domenipavec/usb-vga-computer-control/README.md

# usb-vga-computer-control

## Installation

`sudo apt-get install python-opencv v4l-utils python-pip`
`sudo pip install -r python-software/requirements.txt`
