domenipavec/usb-vga-computer-control/kicad/prototypes/2/prototype1.kicad_pcb

## KiCad design kicad/prototypes/2/prototype1.kicad_pcb (2017-01-03)

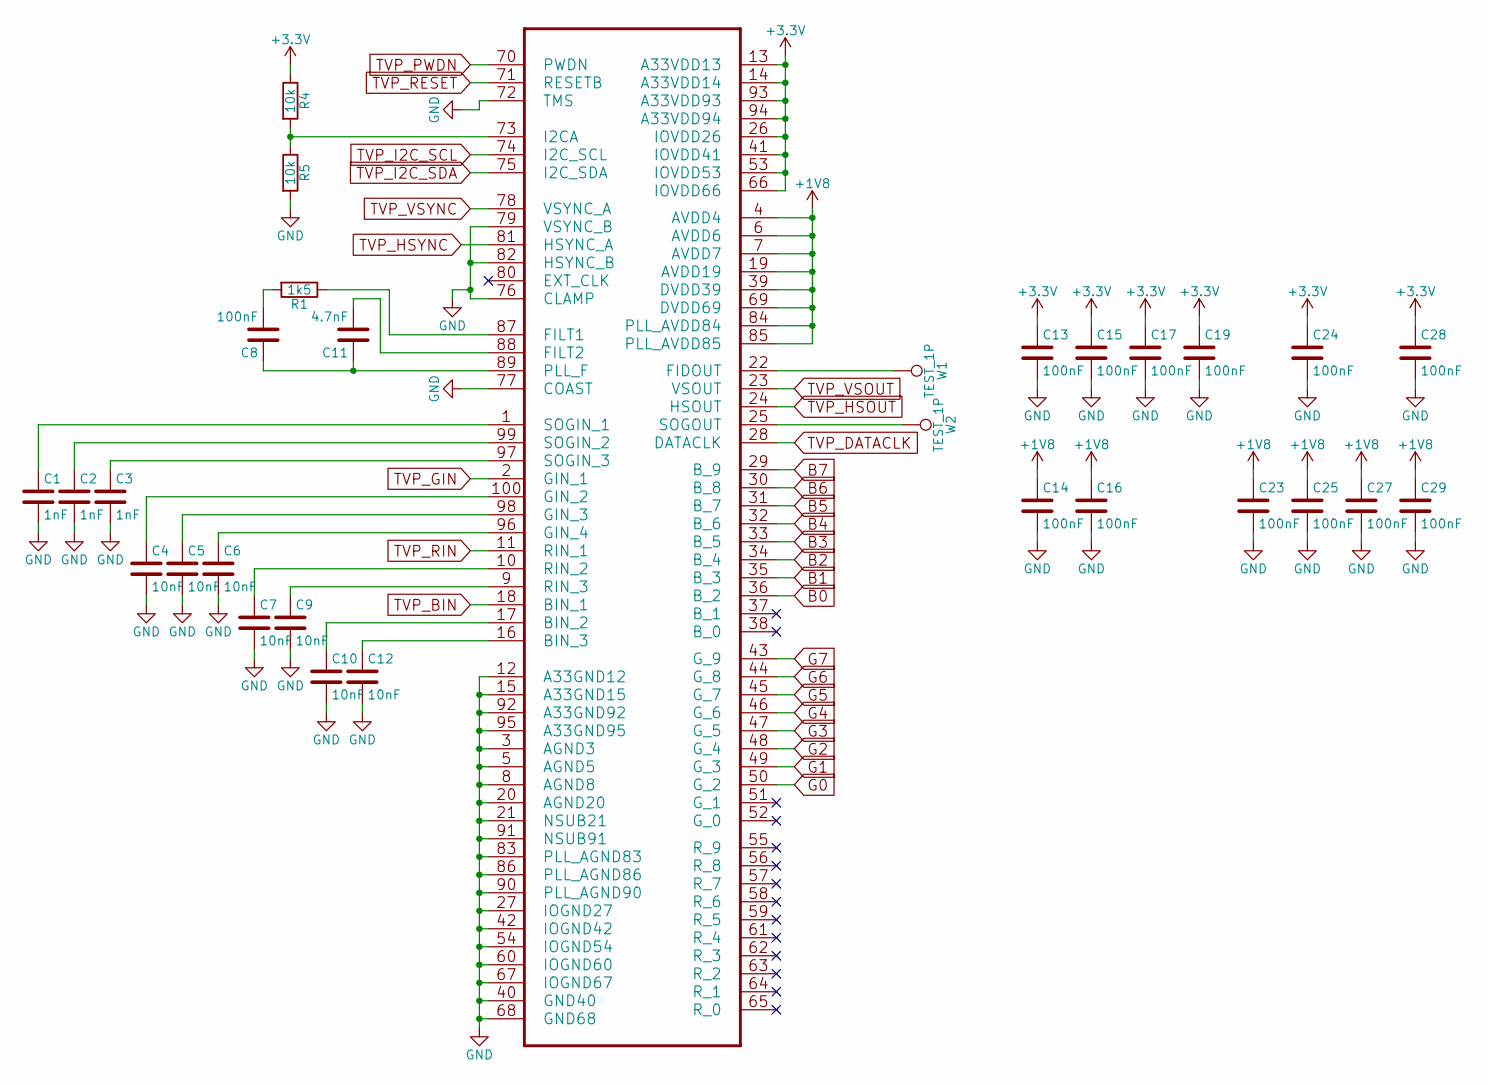
[picture p1: schematic tvp7002.sch]

Parts:
C1, C2, C3: 1nF; C_0402
C4, C5, C6, C7, C9, C10, C12: 10nF; C_0402
C8, C13, C14, C15, C16, C17, C19, C23, C24, C25, C27, C28, C29: 100nF; C_0402
C11: 4.7nF; C_0805
R1: 1k5; R_0805
R4, R5: 10k; R_0805
U1: TVP7002; LQFP-100_14x14mm_Pitch0.5mm
W1, W2: TEST_1P; Measurement_Point_Round-SMD-Pad_Small

Connections:
+1V8: C14.1, C16.1, C23.1, C25.1, C27.1, C29.1, U1.4 (AVDD4), U1.6 (AVDD6), U1.7 (AVDD7), U1.19 (AVDD19), U1.39 (DVDD39), U1.69 (DVDD69), U1.84 (PLL_AVDD84), U1.85 (PLL_AVDD85); also elsewhere on the board
+3V3: C13.1, C15.1, C17.1, C19.1, C24.1, C28.1, R4.1, U1.13 (A33VDD13), U1.14 (A33VDD14), U1.26 (IOVDD26), U1.41 (IOVDD41), U1.53 (IOVDD53), U1.66 (IOVDD66), U1.93 (A33VDD93), U1.94 (A33VDD94); also elsewhere on the board
B0: U1.36 (B_2); also elsewhere on the board
B1: U1.35 (B_3); also elsewhere on the board
B2: U1.34 (B_4); also elsewhere on the board
B3: U1.33 (B_5); also elsewhere on the board
B4: U1.32 (B_6); also elsewhere on the board
B5: U1.31 (B_7); also elsewhere on the board
B6: U1.30 (B_8); also elsewhere on the board
B7: U1.29 (B_9); also elsewhere on the board
G0: U1.50 (G_2); also elsewhere on the board
G1: U1.49 (G_3); also elsewhere on the board
G2: U1.48 (G_4); also elsewhere on the board
G3: U1.47 (G_5); also elsewhere on the board
G4: U1.46 (G_6); also elsewhere on the board
G5: U1.45 (G_7); also elsewhere on the board
G6: U1.44 (G_8); also elsewhere on the board
G7: U1.43 (G_9); also elsewhere on the board
GND: C1.2, C2.2, C3.2, C4.2, C5.2, C6.2, C7.2, C9.2, C10.2, C12.2, C13.2, C14.2, C15.2, C16.2, C17.2, C19.2, C23.2, C24.2, C25.2, C27.2, C28.2, C29.2, R5.2, U1.3 (AGND3), U1.5 (AGND5), U1.8 (AGND8), U1.12 (A33GND12), U1.15 (A33GND15), U1.20 (AGND20), U1.21 (NSUB21), U1.27 (IOGND27), U1.40 (GND40), U1.42 (IOGND42), U1.54 (IOGND54), U1.60 (IOGND60), U1.67 (IOGND67), U1.68 (GND68), U1.72 (TMS), U1.76 (CLAMP), U1.77 (COAST), U1.79 (VSYNC_B), U1.82 (HSYNC_B), U1.83 (PLL_AGND83), U1.86 (PLL_AGND86), U1.90 (PLL_AGND90), U1.91 (NSUB91), U1.92 (A33GND92), U1.95 (A33GND95); also elsewhere on the board
unnamed: C1.1, U1.1 (SOGIN_1)
unnamed: C2.1, U1.99 (SOGIN_2)
unnamed: C3.1, U1.97 (SOGIN_3)
unnamed: C4.1, U1.100 (GIN_2)
unnamed: C5.1, U1.98 (GIN_3)
unnamed: C6.1, U1.96 (GIN_4)
unnamed: C7.1, U1.10 (RIN_2)
unnamed: C8.2, R1.2
unnamed: C9.1, U1.9 (RIN_3)
unnamed: C10.1, U1.17 (BIN_2)
unnamed: C8.1, C11.1, U1.89 (PLL_F)
unnamed: C11.2, U1.88 (FILT2)
unnamed: C12.1, U1.16 (BIN_3)
unnamed: R1.1, U1.87 (FILT1)
unnamed: R4.2, R5.1, U1.73 (I2CA)
unnamed: U1.22 (FIDOUT), W1.1
unnamed: U1.25 (SOGOUT), W2.1
TVP_BIN: U1.18 (BIN_1); also elsewhere on the board
TVP_DATACLK: U1.28 (DATACLK); also elsewhere on the board
TVP_GIN: U1.2 (GIN_1); also elsewhere on the board
TVP_HSOUT: U1.24 (HSOUT); also elsewhere on the board
TVP_HSYNC: U1.81 (HSYNC_A); also elsewhere on the board
TVP_I2C_SCL: U1.74 (I2C_SCL); also elsewhere on the board
TVP_I2C_SDA: U1.75 (I2C_SDA); also elsewhere on the board
TVP_PWDN: U1.70 (PWDN); also elsewhere on the board
TVP_RESET: U1.71 (RESETB); also elsewhere on the board
TVP_RIN: U1.11 (RIN_1); also elsewhere on the board
TVP_VSOUT: U1.23 (VSOUT); also elsewhere on the board
TVP_VSYNC: U1.78 (VSYNC_A); also elsewhere on the board

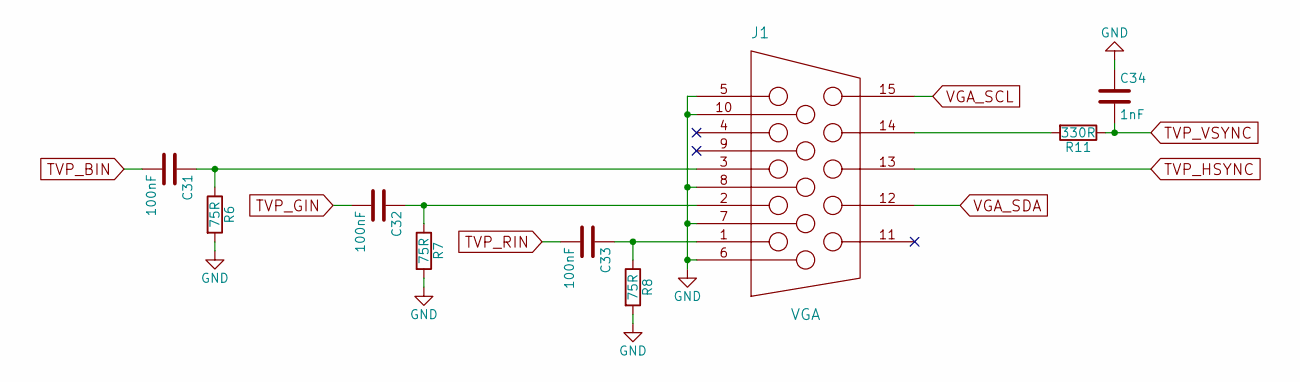
[picture p2: schematic vga.sch]

Parts:
C31, C32, C33: 100nF; C_0402
C34: 1nF; C_0402
J1: VGA
R6, R7, R8: 75R; R_0805
R11: 330R; R_0805

Connections:
AVR_MOSI: J1.12 (ID1/SDA); also elsewhere on the board
AVR_SCK: J1.15 (ID3/SCL); also elsewhere on the board
GND: C34.1, J1.5 (GND_HSYNC), J1.6 (RED_RTN), J1.7 (GREEN_RTN), J1.8 (BLUE_RTN), J1.10 (GND_VSYNC), R6.2, R7.2, R8.2; also elsewhere on the board
unnamed: C31.1, J1.3 (BLUE), R6.1
unnamed: C32.1, J1.2 (GREEN), R7.1
unnamed: C33.1, J1.1 (RED), R8.1
unnamed: J1.14 (VSYNC), R11.2
TVP_BIN: C31.2; also elsewhere on the board
TVP_GIN: C32.2; also elsewhere on the board
TVP_HSYNC: J1.13 (HSYNC); also elsewhere on the board
TVP_RIN: C33.2; also elsewhere on the board
TVP_VSYNC: C34.2, R11.1; also elsewhere on the board

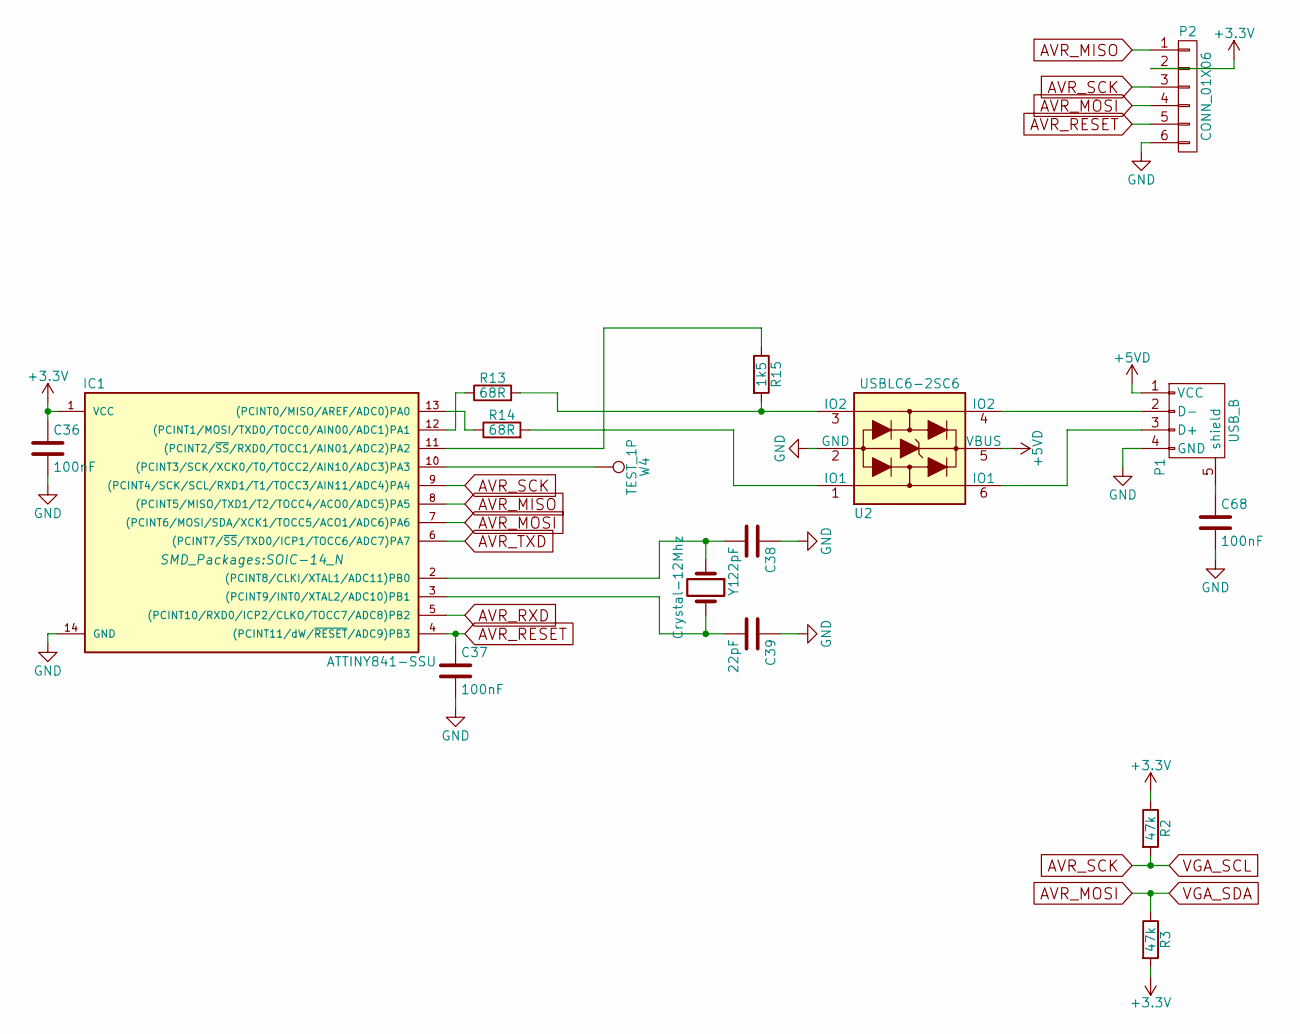
[picture p3: schematic avr.sch]

Parts:
C36, C37, C68: 100nF; C_0402
C38, C39: 22pF; C_0805
IC1: ATTINY841-SSU; SOIC-14_N
P1: USB_B
P2: CONN_01X06; ATTINY841-SPI
R2, R3: 47k; R_0805
R13, R14: 68R; R_0805
R15: 1k5; R_0805
U2: USBLC6-2SC6; SOT-23-6
W4: TEST_1P; Measurement_Point_Round-SMD-Pad_Small
Y1: Crystal-12Mhz; Crystal_HC49-U_Vertical

Connections:
+3V3: C36.1, IC1.1 (VCC), P2.2, R2.1, R3.2; also elsewhere on the board
+5VD: P1.1 (VCC), U2.5 (VBUS)
AVR_MISO: IC1.8 ((PCINT5/MISO/TXD1/T2/TOCC4/ACO0/ADC5)PA5), P2.1
AVR_MOSI: IC1.7 ((PCINT6/MOSI/SDA/XCK1/TOCC5/ACO1/ADC6)P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), P2.4, R3.1; also elsewhere on the board
AVR_RESET: C37.1, IC1.4 ((PCINT11/dW/~RESET~/ADC9)PB3), P2.5
AVR_RXD: IC1.5 ((PCINT10/RXD0/ICP2/CLKO/TOCC7/ADC8)PB2); also elsewhere on the board
AVR_SCK: IC1.9 ((PCINT4/SCK/SCL/RXD1/T1/TOCC3/AIN11/ADC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), P2.3, R2.2; also elsewhere on the board
AVR_TXD: IC1.6 ((PCINT7/~SS~/TXD0/ICP1/TOCC6/ADC7)PA7); also elsewhere on the board
GND: C36.2, C37.2, C38.1, C39.1, C68.2, IC1.14 (GND), P1.4 (GND), P2.6, U2.2 (GND); also elsewhere on the board
unnamed: C38.2, IC1.2 ((PCINT8/CLKI/XTAL1/ADC11)PB0), Y1.1
unnamed: C39.2, IC1.3 ((PCINT9/INT0/XTAL2/ADC10)PB1), Y1.2
unnamed: C68.1, P1.5 (shield)
unnamed: IC1.10 ((PCINT3/SCK/XCK0/T0/TOCC2/AIN10/ADC3)PA3), W4.1
unnamed: IC1.11 ((PCINT2/~SS~/RXD0/TOCC1/AIN01/ADC2)PA2), R15.1
unnamed: IC1.12 ((PCINT1/MOSI/TXD0/TOCC0/AIN00/ADC1)PA1), R13.1
unnamed: IC1.13 ((PCINT0/MISO/AREF/ADC0)PA0), R14.1
unnamed: P1.2 (D-), U2.4 (IO2)
unnamed: P1.3 (D+), U2.6 (IO1)
unnamed: R13.2, R15.2, U2.3 (IO2)
unnamed: R14.2, U2.1 (IO1)

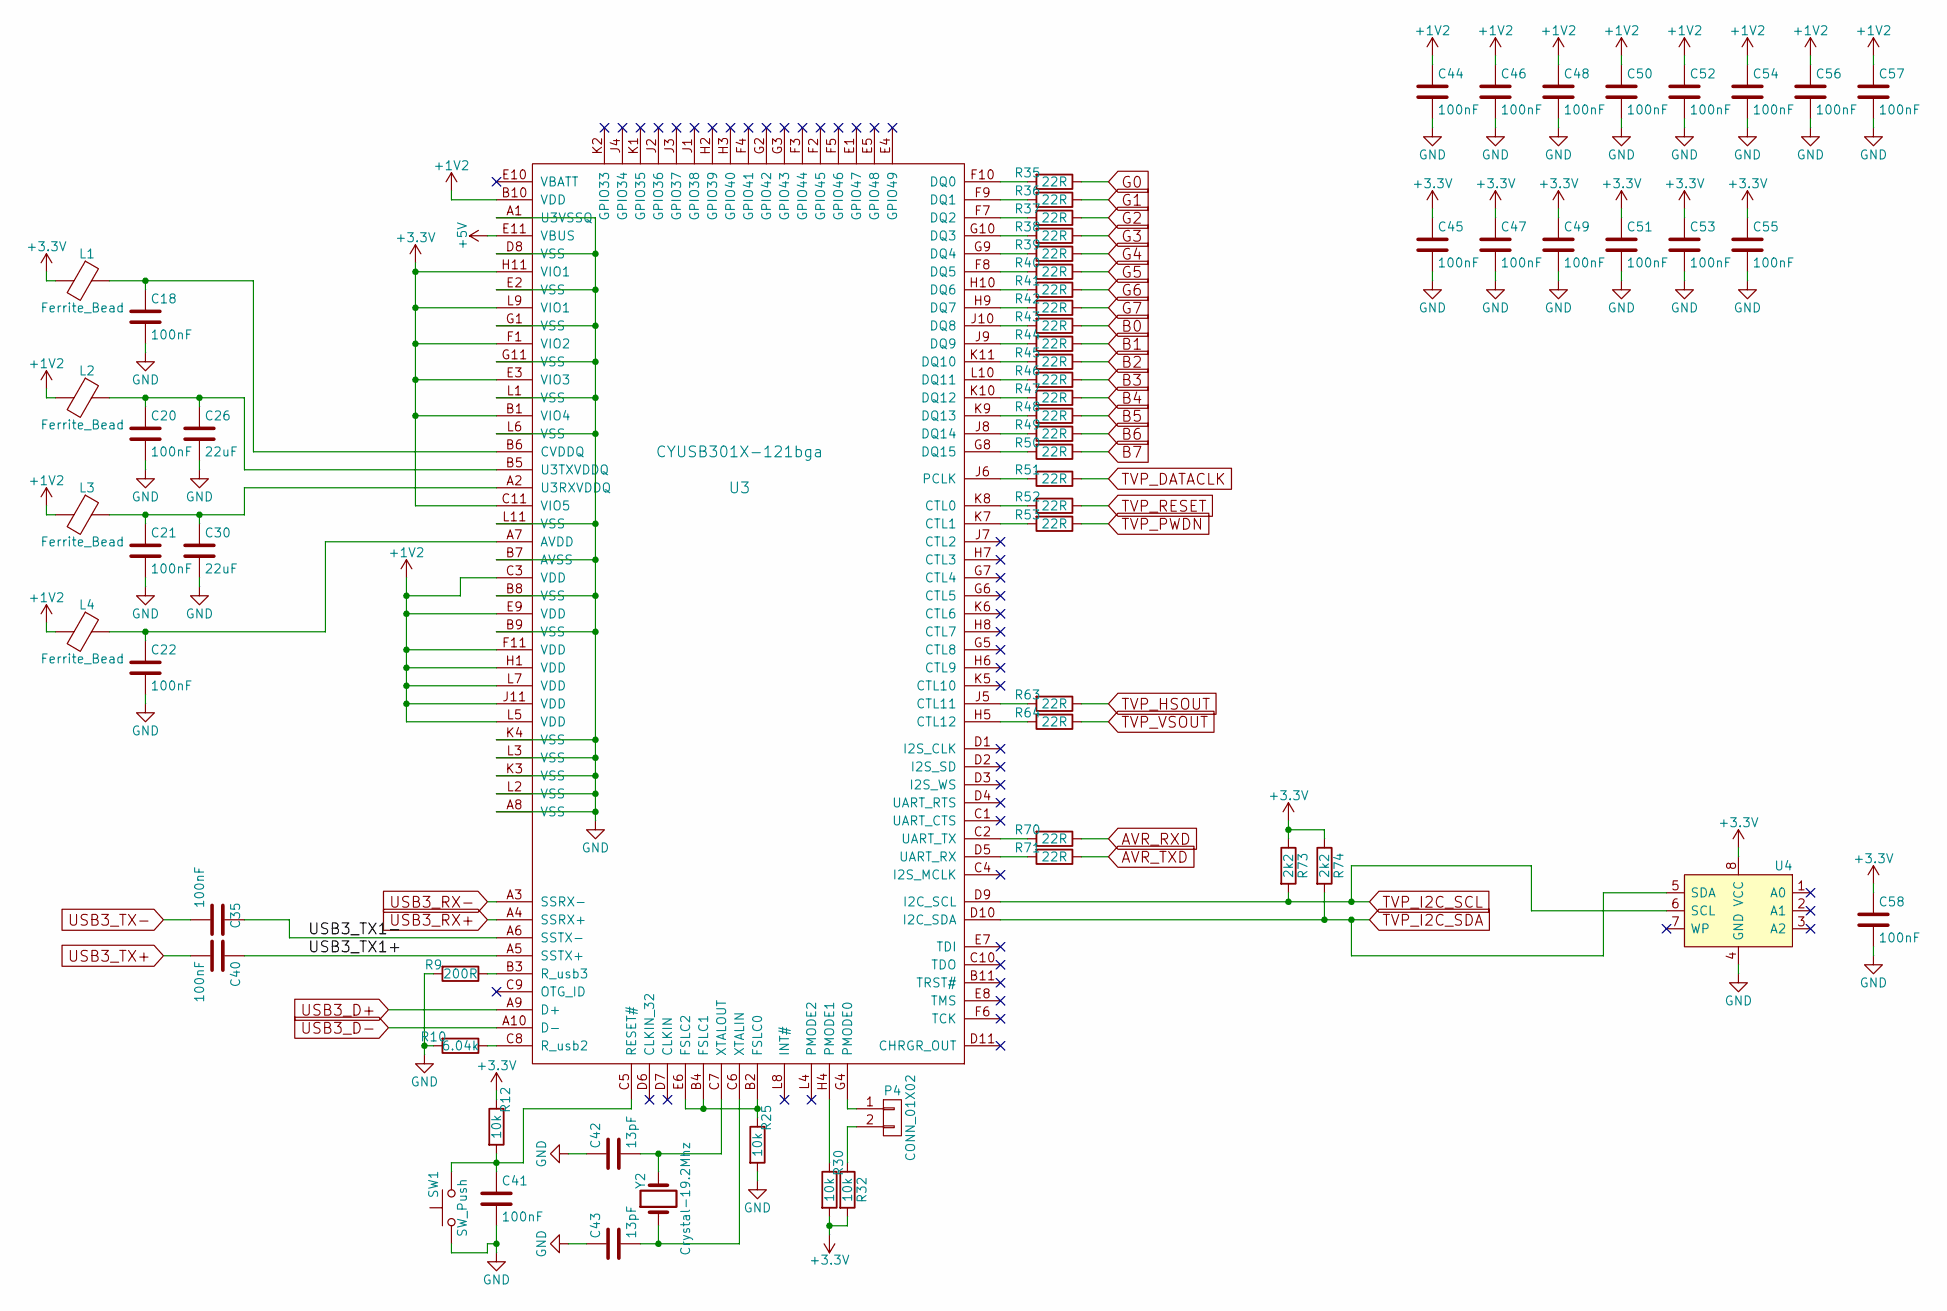
[picture p4: schematic cyusb.sch]

Parts:
C18, C20, C21, C22, C35, C40, C41, C44, C45, C46, C47, C48, C49, C50, C51, C52, C53, C54, C55, C56, C57, C58: 100nF; C_0402
C26, C30: 22uF; C_1206
C42, C43: 13pF; C_0805
L1, L2, L3, L4: Ferrite_Bead; R_0805
P4: CONN_01X02; Socket_Strip_Straight_1x02
R9: 200R; R_0402
R10: 6.04k; R_0402
R12, R25, R30, R32: 10k; R_0805
R35, R36, R37, R38, R39, R40, R41, R42, R43, R44, R45, R46, R47, R48, R49, R50, R51, R52, R53, R63, R64, R70, R71: 22R; R_0402
R73, R74: 2k2; R_0805
SW1: SW_Push; pushbutton
U3: CYUSB301X-121bga; BGA_121
U4: 24LC16; SOIC-8_3.9x4.9mm_Pitch1.27mm
Y2: Crystal-19.2Mhz; Crystal_HC49-U_Vertical

Connections:
+1V2: C44.1, C46.1, C48.1, C50.1, C52.1, C54.1, C56.1, C57.1, L2.2, L3.2, L4.2, U3.B10 (VDD), U3.C3 (VDD), U3.E9 (VDD), U3.F11 (VDD), U3.H1 (VDD), U3.J11 (VDD), U3.L5 (VDD), U3.L7 (VDD); also elsewhere on the board
+3V3: C45.1, C47.1, C49.1, C51.1, C53.1, C55.1, C58.1, L1.2, R12.1, R30.2, R32.2, R73.1, R74.1, U3.B1 (VIO4), U3.C11 (VIO5), U3.E3 (VIO3), U3.F1 (VIO2), U3.H11 (VIO1), U3.L9 (VIO1), U4.8 (VCC); also elsewhere on the board
+5V: U3.E11 (VBUS); also elsewhere on the board
/cyusb/USB3_TX1+: C40.1, U3.A5 (SSTX+)
/cyusb/USB3_TX1-: C35.1, U3.A6 (SSTX-)
AVR_RXD: R70.1; also elsewhere on the board
AVR_TXD: R71.1; also elsewhere on the board
B0: R43.1; also elsewhere on the board
B1: R44.1; also elsewhere on the board
B2: R45.1; also elsewhere on the board
B3: R46.1; also elsewhere on the board
B4: R47.1; also elsewhere on the board
B5: R48.1; also elsewhere on the board
B6: R49.1; also elsewhere on the board
B7: R50.1; also elsewhere on the board
G0: R35.1; also elsewhere on the board
G1: R36.1; also elsewhere on the board
G2: R37.1; also elsewhere on the board
G3: R38.1; also elsewhere on the board
G4: R39.1; also elsewhere on the board
G5: R40.1; also elsewhere on the board
G6: R41.1; also elsewhere on the board
G7: R42.1; also elsewhere on the board
GND: C18.2, C20.2, C21.2, C22.2, C26.2, C30.2, C41.2, C42.1, C43.1, C44.2, C45.2, C46.2, C47.2, C48.2, C49.2, C50.2, C51.2, C52.2, C53.2, C54.2, C55.2, C56.2, C57.2, C58.2, R9.2, R10.2, R25.2, SW1.1, U3.A1 (U3VSSQ), U3.A8 (VSS), U3.B7 (AVSS), U3.B8 (VSS), U3.B9 (VSS), U3.D8 (VSS), U3.E2 (VSS), U3.G1 (VSS), U3.G11 (VSS), U3.K3 (VSS), U3.K4 (VSS), U3.L1 (VSS), U3.L2 (VSS), U3.L3 (VSS), U3.L6 (VSS), U3.L11 (VSS), U4.4 (GND); also elsewhere on the board
unnamed: C18.1, L1.1, U3.B6 (CVDDQ)
unnamed: C20.1, C26.1, L2.1, U3.B5 (U3TXVDDQ)
unnamed: C21.1, C30.1, L3.1, U3.A2 (U3RXVDDQ)
unnamed: C22.1, L4.1, U3.A7 (AVDD)
unnamed: C41.1, R12.2, SW1.2, U3.C5 (RESET#)
unnamed: C42.2, U3.C7 (XTALOUT), Y2.2
unnamed: C43.2, U3.C6 (XTALIN), Y2.1
unnamed: P4.1, U3.G4 (PMODE0)
unnamed: P4.2, R32.1
unnamed: R9.1, U3.B3 (R_usb3)
unnamed: R10.1, U3.C8 (R_usb2)
unnamed: R25.1, U3.B2 (FSLC0), U3.B4 (FSLC1), U3.E6 (FSLC2)
unnamed: R30.1, U3.H4 (PMODE1)
unnamed: R35.2, U3.F10 (DQ0)
unnamed: R36.2, U3.F9 (DQ1)
unnamed: R37.2, U3.F7 (DQ2)
unnamed: R38.2, U3.G10 (DQ3)
unnamed: R39.2, U3.G9 (DQ4)
unnamed: R40.2, U3.F8 (DQ5)
unnamed: R41.2, U3.H10 (DQ6)
unnamed: R42.2, U3.H9 (DQ7)
unnamed: R43.2, U3.J10 (DQ8)
unnamed: R44.2, U3.J9 (DQ9)
unnamed: R45.2, U3.K11 (DQ10)
unnamed: R46.2, U3.L10 (DQ11)
unnamed: R47.2, U3.K10 (DQ12)
unnamed: R48.2, U3.K9 (DQ13)
unnamed: R49.2, U3.J8 (DQ14)
unnamed: R50.2, U3.G8 (DQ15)
unnamed: R51.2, U3.J6 (PCLK)
unnamed: R52.2, U3.K8 (CTL0)
unnamed: R53.2, U3.K7 (CTL1)
unnamed: R63.2, U3.J5 (CTL11)
unnamed: R64.2, U3.H5 (CTL12)
unnamed: R70.2, U3.C2 (UART_TX)
unnamed: R71.2, U3.D5 (UART_RX)
TVP_DATACLK: R51.1; also elsewhere on the board
TVP_HSOUT: R63.1; also elsewhere on the board
TVP_I2C_SCL: R73.2, U3.D9 (I2C_SCL), U4.6 (SCL); also elsewhere on the board
TVP_I2C_SDA: R74.2, U3.D10 (I2C_SDA), U4.5 (SDA); also elsewhere on the board
TVP_PWDN: R53.1; also elsewhere on the board
TVP_RESET: R52.1; also elsewhere on the board
TVP_VSOUT: R64.1; also elsewhere on the board
USB3_D+: U3.A9 (D+); also elsewhere on the board
USB3_D-: U3.A10 (D-); also elsewhere on the board
USB3_RX+: U3.A4 (SSRX+); also elsewhere on the board
USB3_RX-: U3.A3 (SSRX-); also elsewhere on the board
USB3_TX+: C40.2; also elsewhere on the board
USB3_TX-: C35.2; also elsewhere on the board

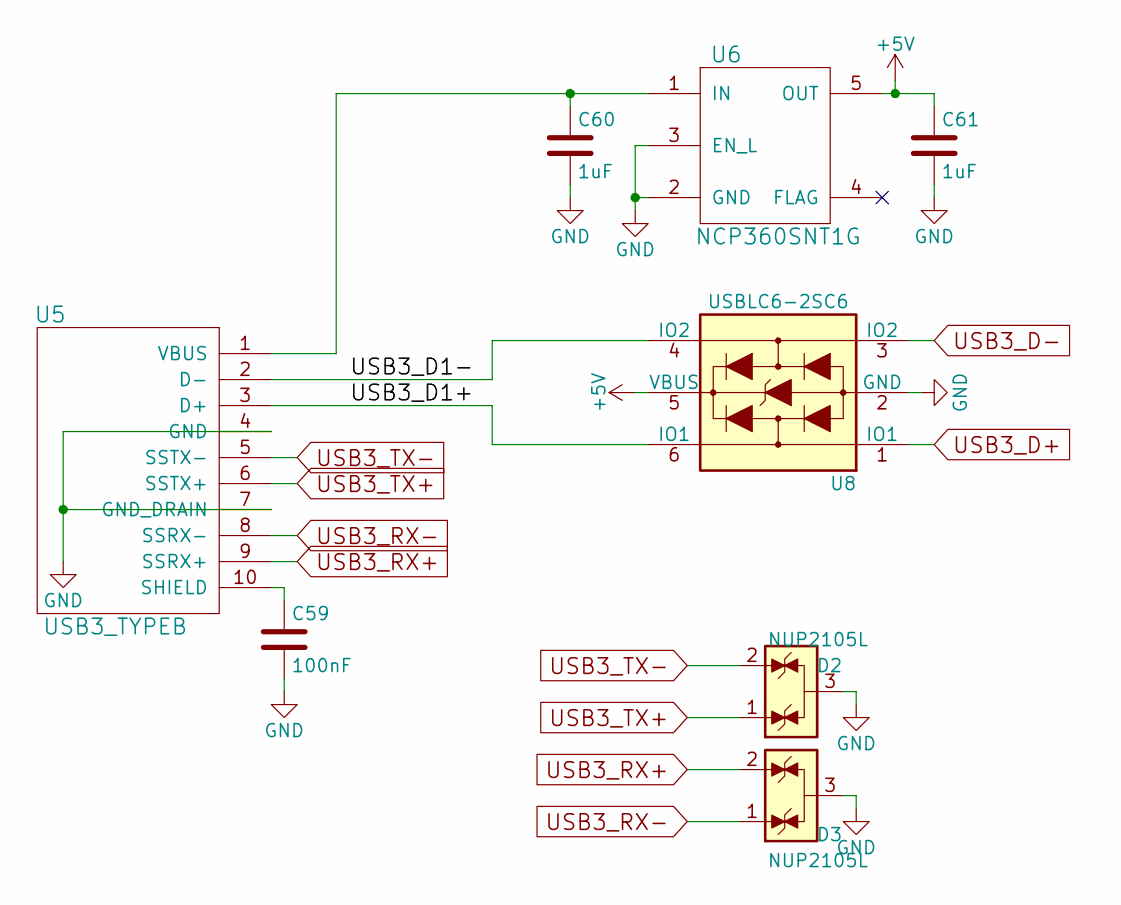
[picture p5: schematic usb3.sch]

Parts:
C59: 100nF; C_0402
C60, C61: 1uF; C_0805
D2, D3: NUP2105L; DRT
U5: USB3_TYPEB; USB3_TYPE_B
U6: NCP360SNT1G; SOT-23-5
U8: USBLC6-2SC6; SOT-23-6

Connections:
+5V: C61.1, U6.5 (OUT), U8.5 (VBUS); also elsewhere on the board
/usb3/USB3_D1+: U5.3 (D+), U8.6 (IO1)
/usb3/USB3_D1-: U5.2 (D-), U8.4 (IO2)
GND: C59.2, C60.2, C61.2, D2.3 (A), D3.3 (A), U5.4 (GND), U5.7 (GND_DRAIN), U6.2 (GND), U6.3 (EN_L), U8.2 (GND); also elsewhere on the board
unnamed: C59.1, U5.10 (SHIELD)
unnamed: C60.1, U5.1 (VBUS), U6.1 (IN)
USB3_D+: U8.1 (IO1); also elsewhere on the board
USB3_D-: U8.3 (IO2); also elsewhere on the board
USB3_RX+: D3.2 (K), U5.9 (SSRX+); also elsewhere on the board
USB3_RX-: D3.1 (K), U5.8 (SSRX-); also elsewhere on the board
USB3_TX+: D2.1 (K), U5.6 (SSTX+); also elsewhere on the board
USB3_TX-: D2.2 (K), U5.5 (SSTX-); also elsewhere on the board

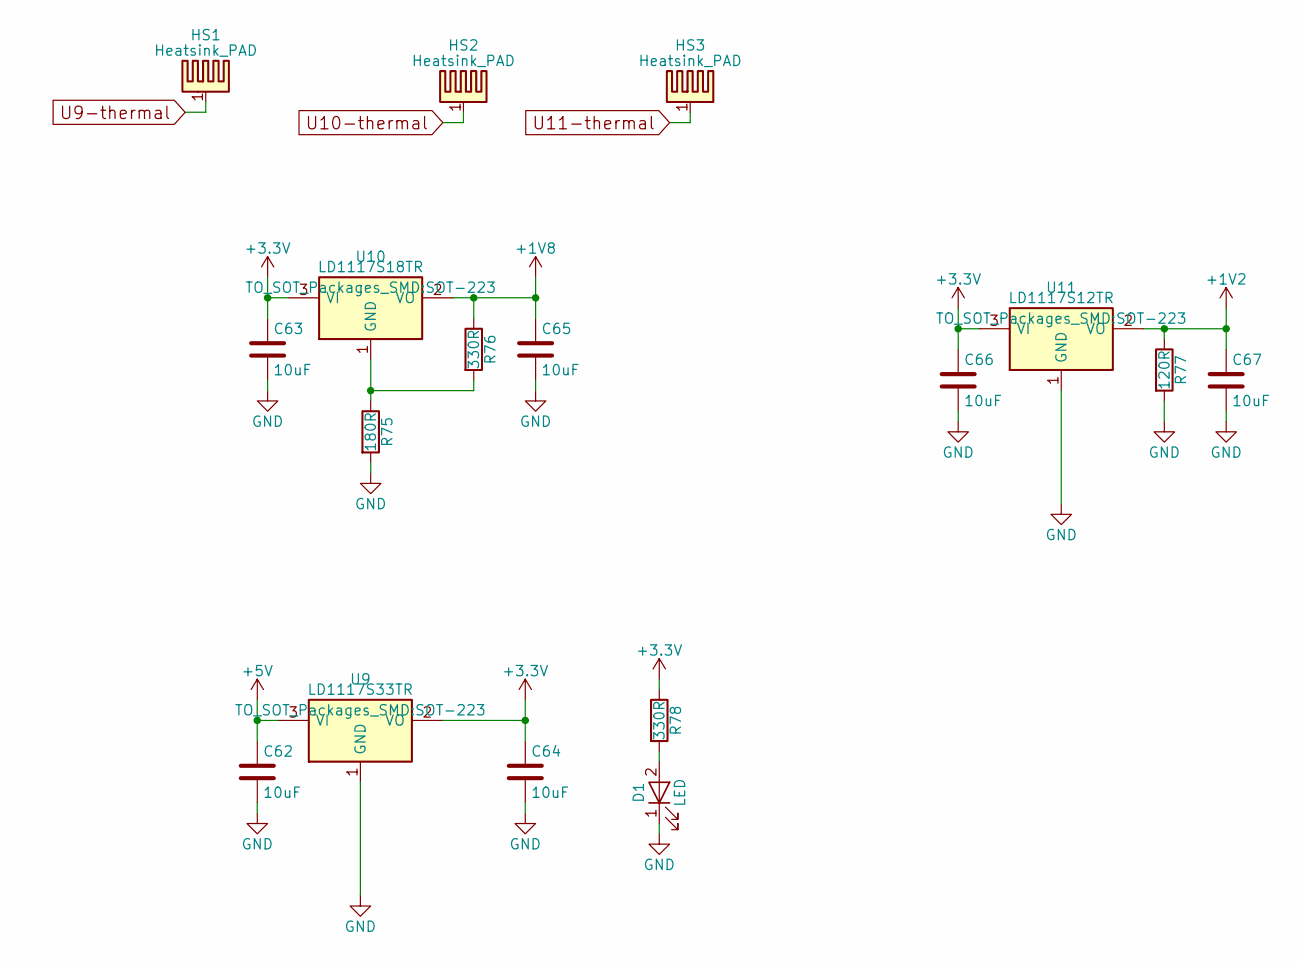
[picture p6: schematic power.sch]

Parts:
C62, C63, C64, C65, C66, C67: 10uF; C_0805
D1: LED; LED-3MM
HS1, HS2, HS3: Heatsink_PAD; Measurement_Point_Round-SMD-Pad_Small
R75: 180R; R_0805
R76, R78: 330R; R_0805
R77: 120R; R_0805
U9: LD1117S33TR; SOT-223
U10: LD1117S18TR; SOT-223
U11: LD1117S12TR; SOT-223

Connections:
+1V2: C67.1, R77.1, U11.2 (VO); also elsewhere on the board
+1V8: C65.1, R76.1, U10.2 (VO); also elsewhere on the board
+3V3: C63.1, C64.1, C66.1, R78.1, U9.2 (VO), U10.3 (VI), U11.3 (VI); also elsewhere on the board
+5V: C62.1, U9.3 (VI); also elsewhere on the board
GND: C62.2, C63.2, C64.2, C65.2, C66.2, C67.2, D1.1 (K), R75.2, R77.2, U9.1 (GND), U11.1 (GND); also elsewhere on the board
unnamed: D1.2 (A), R78.2
unnamed: R75.1, R76.2, U10.1 (GND)
U9-thermal: U9.4
U10-thermal: U10.4
U11-thermal: U11.4

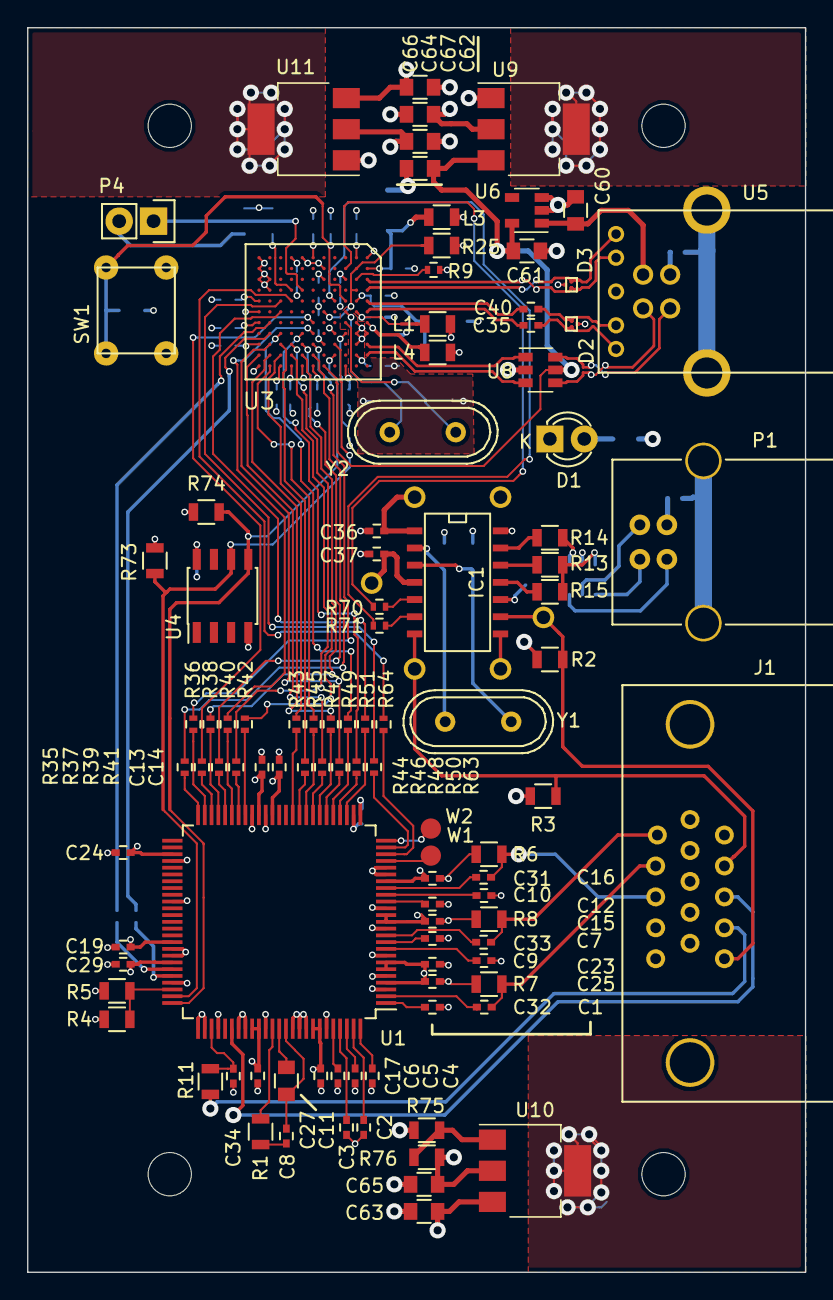
[picture p7: board prototype1.kicad_pcb from above]

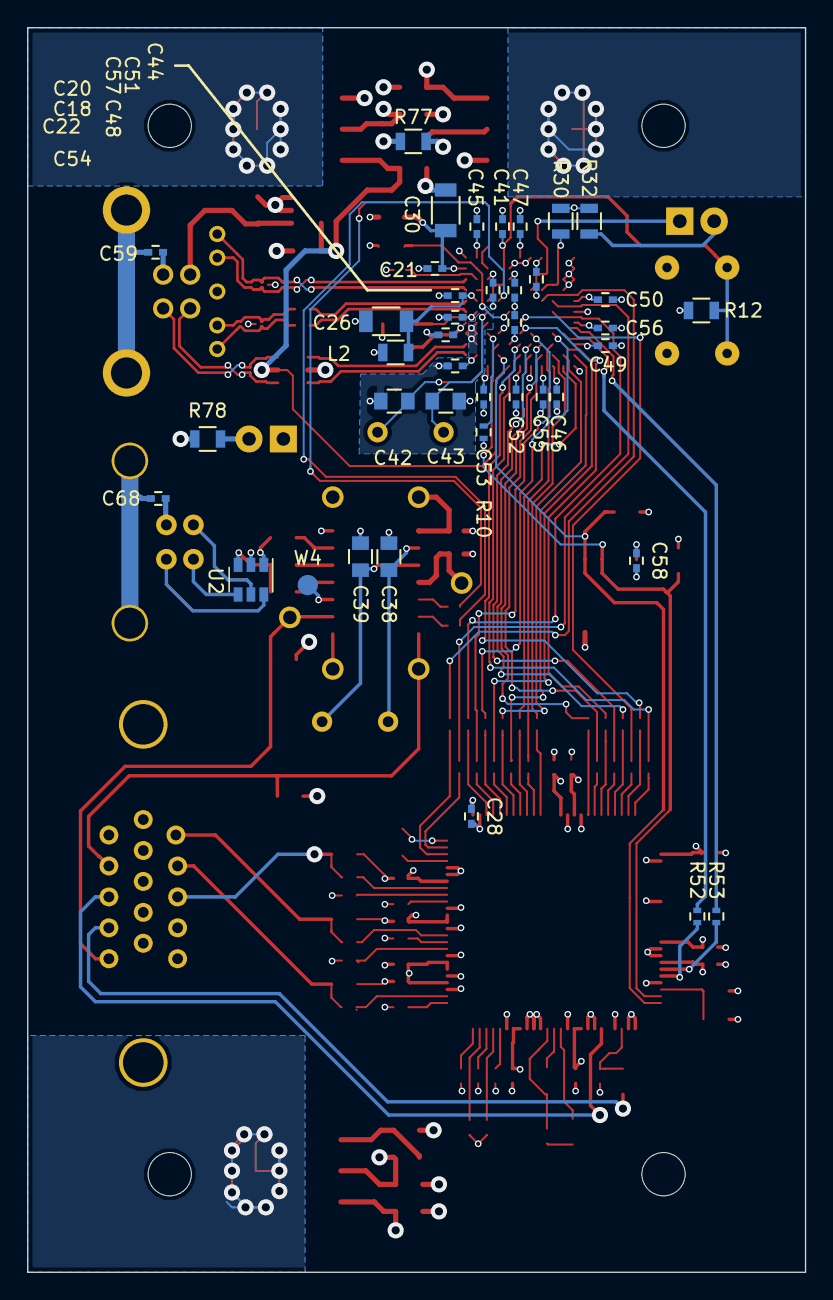
[picture p8: board prototype1.kicad_pcb from below]

Board: 4 copper layers, 57.5 x 92.0 mm, 143 parts (41 on the bottom side), 122 nets.
