domenipavec/usb-vga-computer-control/avr-firmware/main.cpp

/* File: main.cpp
 * Contains base main function and usually all the other stuff that avr does...
 */
/* Copyright (c) 2012-2013 Domen Ipavec (domen.ipavec@z-v.si)
 *
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
 * THE SOFTWARE IS PROVIDED "AS IS", WITHOUT WARRANTY OF ANY KIND,
 * EXPRESS OR IMPLIED, INCLUDING BUT NOT LIMITED TO THE WARRANTIES OF
 * MERCHANTABILITY, FITNESS FOR A PARTICULAR PURPOSE AND
 * NONINFRINGEMENT. IN NO EVENT SHALL THE AUTHORS OR COPYRIGHT HOLDERS
 * BE LIABLE FOR ANY CLAIM, DAMAGES OR OTHER LIABILITY, WHETHER IN AN
 * ACTION OF CONTRACT, TORT OR OTHERWISE, ARISING FROM, OUT OF OR IN
 * CONNECTION WITH THE SOFTWARE OR THE USE OR OTHER DEALINGS IN THE
 * SOFTWARE.
 */

// #include <util/delay.h>

// #include <avr/io.h>
#include <avr/interrupt.h>
//#include <avr/pgmspace.h>
// #include <avr/eeprom.h>

// #include <stdint.h>
// #include <stdlib.h>

#include "i2c.h"
#include "usb.h"
#include "uart.h"


int main() {
	usb_init();
	uart_init();
	i2c_init();

	// enable interrupts
	sei();

	for (;;) {
		usb_loop();
	}
}
