domenipavec/usb-vga-computer-control/cyusb-firmware/uvc.c

/*
## Cypress FX3 Camera Kit Source file (uvc.c)
## ===========================
##
##  Copyright Cypress Semiconductor Corporation, 2010-2012,
##  All Rights Reserved
##  UNPUBLISHED, LICENSED SOFTWARE.
##
##  CONFIDENTIAL AND PROPRIETARY INFORMATION
##  WHICH IS THE PROPERTY OF CYPRESS.
##
##  Use of this file is governed
##  by the license agreement included in the file
##
##     <install>/license/license.txt
##
##  where <install> is the Cypress software
##  installation root directory path.
##
## ===========================
*/

/* This project implements a USB Video Class device that streams uncompressed video
   data from an image sensor to a USB host PC.

   Please refer to the Cypress Application Note: "AN75779: Interfacing an Image
   Sensor to EZ-USB FX3 in a USB video class (UVC) Framework" (http://www.cypress.com/?rID=62824)
   for a detailed design description of this application.

   As the UVC class driver on Windows hosts does not support burst enabled Isochronous
   endpoints on USB 3.0, this implementation makes use of Bulk endpoints for the video
   streaming.

   Two video formats are supported when the system functions on a USB 3.0 link:
   1. 720p (1280 * 720) video at 30 fps
   2. VGA (640 * 480) video at 15 fps
   Only the VGA video stream is supported on a USB 2.0 link, due to bandwidth limitations.

   The video streaming is accomplished with the help of a many-to-one manual DMA channel.
   Two producer sockets are used to receive data on the GPIF side to prevent data loss. The
   data is aggregated into one pipe and sent to the USB host over a bulk endpoint; after the
   addition of appropriate UVC headers.

   This firmware application makes use of two threads:
   1. The video streaming thread is responsible for handling the USB video streaming.
   If the UVC host has enabled video streaming, this thread continuously waits for
   a filled buffer, adds the appropriate UVC headers and commits the data. This
   thread also ensures the DMA multi-channel is reset and restarted at the end of
   each video frame. This thread is only idle when the UVC host has not enable video
   streaming.
   2. The UVC control thread handles UVC class specific requests that arrive on the
   control endpoint. The USB setup callback sets up events to notify this thread that
   a request has been received, and the thread handles them as soon as possible.
   */

#include <cyu3system.h>
#include <cyu3os.h>
#include <cyu3dma.h>
#include <cyu3error.h>
#include <cyu3usb.h>
#include <cyu3uart.h>
#include <cyu3gpif.h>
#include <cyu3i2c.h>
#include <cyu3gpio.h>
#include <cyu3pib.h>
#include <cyu3utils.h>
#include <cyu3socket.h>

#include "uvc.h"
#include "tvp7002.h"
#include "uart.h"
#include "cyfxgpif2config.h"
#include "usb_descriptors.h"

/*************************************************************************************************
  Global Variables
 *************************************************************************************************/
static CyU3PEvent    glFxUVCEvent;                      /* Event group used to signal threads. */
CyU3PDmaMultiChannel glChHandleUVCStream;               /* DMA multi-channel handle. */

/* Current UVC control request fields. See USB specification for definition. */
uint8_t  bmReqType, bRequest;                           /* bmReqType and bRequest fields. */
uint16_t wValue, wIndex, wLength;                       /* wValue, wIndex and wLength fields. */

CyU3PUSBSpeed_t usbSpeed = CY_U3P_NOT_CONNECTED;        /* Current USB connection speed. */
CyBool_t        clearFeatureRqtReceived = CyFalse;      /* Whether a CLEAR_FEATURE (stop streaming) request has been
														   received. */
CyBool_t        streamingStarted = CyFalse;             /* Whether USB host has started streaming data */

#ifdef BACKFLOW_DETECT
uint8_t back_flow_detected = 0;                         /* Whether buffer overflow error is detected. */
#endif

/* UVC Probe Control Settings for a USB 3.0 connection. */
uint8_t glProbeCtrl[CY_FX_UVC_MAX_PROBE_SETTING] = {
	0x00, 0x00,                 /* bmHint : no hit */
	0x01,                       /* Use 1st Video format index */
	0x01,                       /* Use 1st Video frame index */
	0x0b, 0x8b, 0x02, 0x00,     /* Desired frame interval in the unit of 100ns: 30 fps */
	0x00, 0x00,                 /* Key frame rate in key frame/video frame units: only applicable
								   to video streaming with adjustable compression parameters */
	0x00, 0x00,                 /* PFrame rate in PFrame / key frame units: only applicable to
								   video streaming with adjustable compression parameters */
	0x00, 0x00,                 /* Compression quality control: only applicable to video streaming
								   with adjustable compression parameters */
	0x00, 0x00,                 /* Window size for average bit rate: only applicable to video
								   streaming with adjustable compression parameters */
	0x00, 0x00,                 /* Internal video streaming i/f latency in ms */
	0x00, 0x60, 0x09, 0x00,     /* Max video frame size in bytes */
	0x00, 0x40, 0x00, 0x00      /* No. of bytes device can rx in single payload = 16 KB */
};

/* UVC Probe Control Setting for a USB 2.0 connection. */
uint8_t glProbeCtrl20[CY_FX_UVC_MAX_PROBE_SETTING] = {
	0x00, 0x00,                 /* bmHint : no hit */
	0x01,                       /* Use 1st Video format index */
	0x01,                       /* Use 1st Video frame index */
	0x2A, 0x2C, 0x0A, 0x00,     /* Desired frame interval in the unit of 100ns: 15 fps */
	0x00, 0x00,                 /* Key frame rate in key frame/video frame units: only applicable
								   to video streaming with adjustable compression parameters */
	0x00, 0x00,                 /* PFrame rate in PFrame / key frame units: only applicable to
								   video streaming with adjustable compression parameters */
	0x00, 0x00,                 /* Compression quality control: only applicable to video streaming
								   with adjustable compression parameters */
	0x00, 0x00,                 /* Window size for average bit rate: only applicable to video
								   streaming with adjustable compression parameters */
	0x00, 0x00,                 /* Internal video streaming i/f latency in ms */
	0x00, 0x60, 0x09, 0x00,     /* Max video frame size in bytes */
	0x00, 0x40, 0x00, 0x00      /* No. of bytes device can rx in single payload = 16 KB */
};

/* Video Probe Commit Control. This array is filled out when the host sends down the SET_CUR request. */
static uint8_t glCommitCtrl[CY_FX_UVC_MAX_PROBE_SETTING_ALIGNED];

/* Scratch buffer used for handling UVC class requests with a data phase. */
static uint8_t glEp0Buffer[32];

/* UVC Header to be prefixed at the top of each 16 KB video data buffer. */
uint8_t volatile glUVCHeader[CY_FX_UVC_MAX_HEADER] =
{
	0x0C,                               /* Header Length */
	0x8C,                               /* Bit field header field */
	0x00, 0x00, 0x00, 0x00,             /* Presentation time stamp field */
	0x00, 0x00, 0x00, 0x00, 0x00, 0x00  /* Source clock reference field */
};

#ifdef DEBUG_PRINT_FRAME_COUNT
volatile static uint32_t glFrameCount = 0;              /* Number of video frames transferred so far. */
volatile static uint32_t glDmaDone = 1;                 /* Number of buffers transferred in the current frame. */
volatile static uint32_t glForceWrap = 0;
volatile static uint32_t glEndFull = 0;
#endif

/* Add the UVC packet header to the top of the specified DMA buffer. */
	void
CyFxUVCAddHeader (
		uint8_t *buffer_p,              /* Buffer pointer */
		uint8_t frameInd                /* EOF or normal frame indication */
		)
{
	/* Copy header to buffer */
	CyU3PMemCopy (buffer_p, (uint8_t *)glUVCHeader, CY_FX_UVC_MAX_HEADER);

	/* The EOF flag needs to be set if this is the last packet for this video frame. */
	if (frameInd & CY_FX_UVC_HEADER_EOF)
	{
		buffer_p[1] |= CY_FX_UVC_HEADER_EOF;
		glUVCHeader[1] ^= CY_FX_UVC_HEADER_FRAME_ID;
	}
}


/* Application Error Handler */
	void
CyFxAppErrorHandler (
		CyU3PReturnStatus_t apiRetStatus    /* API return status */
		)
{
	/* This function is hit when we have hit a critical application error. This is not
	   expected to happen, and the current implementation of this function does nothing
	   except stay in a loop printing error messages through the UART port.

	   This function can be modified to take additional error handling actions such
	   as cycling the USB connection or performing a warm reset.
	   */
	for (;;)
	{
		CyU3PDebugPrint (4, "Error handler...\r\n");
		CyU3PThreadSleep (1000);
	}
}

/* This function performs the operations for a Video Streaming Abort.
   This is called every time there is a USB reset, suspend or disconnect event.
   */
	static void
CyFxUVCApplnAbortHandler (
		void)
{
	/* Set Video Stream Abort Event */
	CyU3PEventSet (&glFxUVCEvent, CY_FX_UVC_STREAM_ABORT_EVENT, CYU3P_EVENT_OR);
}

/* This is the Callback function to handle the USB Events */
	static void
CyFxUVCApplnUSBEventCB (
		CyU3PUsbEventType_t evtype,  /* Event type */
		uint16_t             evdata  /* Event data */
		)
{
	switch (evtype)
	{
		case CY_U3P_USB_EVENT_SETCONF:
			uart_stop();
			uart_start();
			break;

		case CY_U3P_USB_EVENT_CONNECT:
			uart_stop();
			break;

		case CY_U3P_USB_EVENT_RESET:
			CyU3PDebugPrint (4, "RESET encountered...\r\n");
			CyU3PGpifDisable (CyFalse);
			streamingStarted = CyFalse;
			CyFxUVCApplnAbortHandler ();

			uart_stop();
			break;

		case CY_U3P_USB_EVENT_SUSPEND:
			CyU3PDebugPrint (4, "SUSPEND encountered...\r\n");
			CyU3PGpifDisable (CyFalse);
			streamingStarted = CyFalse;
			CyFxUVCApplnAbortHandler ();
			break;

		case CY_U3P_USB_EVENT_DISCONNECT:
			CyU3PDebugPrint (4, "USB disconnected...\r\n");
			CyU3PGpifDisable (CyFalse);
			streamingStarted = CyFalse;
			CyFxUVCApplnAbortHandler ();

			uart_stop();
			break;

		case CY_U3P_USB_EVENT_EP_UNDERRUN:
			CyU3PDebugPrint (4, "CY_U3P_USB_EVENT_EP_UNDERRUN encountered...\r\n");
			break;

		default:
			break;
	}
}

static CyBool_t uvc_usb_setup_cb() {
	uint32_t status;
	CyBool_t uvcHandleReq = CyFalse;

	/* Check for UVC Class Requests */
	switch (bmReqType)
	{
		case CY_FX_USB_UVC_GET_REQ_TYPE:
		case CY_FX_USB_UVC_SET_REQ_TYPE:
			/* UVC Specific requests are handled in the EP0 thread. */
			switch (wIndex & 0xFF)
			{
				case CY_FX_UVC_CONTROL_INTERFACE:
					{
						uvcHandleReq = CyTrue;
						status = CyU3PEventSet (&glFxUVCEvent, CY_FX_UVC_VIDEO_CONTROL_REQUEST_EVENT,
								CYU3P_EVENT_OR);
						if (status != CY_U3P_SUCCESS)
						{
							CyU3PDebugPrint (4, "Set CY_FX_UVC_VIDEO_CONTROL_REQUEST_EVENT Failed %x\n", status);
							CyU3PUsbStall (0, CyTrue, CyFalse);
						}
					}
					break;

				case CY_FX_UVC_STREAM_INTERFACE:
					{
						uvcHandleReq = CyTrue;
						status = CyU3PEventSet (&glFxUVCEvent, CY_FX_UVC_VIDEO_STREAM_REQUEST_EVENT,
								CYU3P_EVENT_OR);
						if (status != CY_U3P_SUCCESS)
						{
							/* Error handling */
							CyU3PDebugPrint (4, "Set CY_FX_UVC_VIDEO_STREAM_REQUEST_EVENT Failed %x\n", status);
							CyU3PUsbStall (0, CyTrue, CyFalse);
						}
					}
					break;

				default:
					break;
			}
			break;

		case CY_FX_USB_SET_INTF_REQ_TYPE:
			if (bRequest == CY_FX_USB_SET_INTERFACE_REQ)
			{
				/* Some hosts send Set Interface Alternate Setting 0 command while stopping the video
				 * stream. The application uses this event to stop streaming. */
				if ((wIndex == CY_FX_UVC_STREAM_INTERFACE) && (wValue == 0))
				{
					/* Stop GPIF state machine to stop data transfers through FX3 */
					CyU3PDebugPrint (4, "Alternate setting 0..\r\n");

					CyU3PGpifDisable (CyFalse);
					streamingStarted = CyFalse;

					/* Place the EP in NAK mode before cleaning up the pipe. */
					CyU3PUsbSetEpNak (CY_FX_EP_BULK_VIDEO, CyTrue);
					CyU3PBusyWait (100);

					/* Reset and flush the endpoint pipe. */
					CyU3PDmaMultiChannelReset (&glChHandleUVCStream);
					CyU3PUsbFlushEp (CY_FX_EP_BULK_VIDEO);
					CyU3PUsbSetEpNak (CY_FX_EP_BULK_VIDEO, CyFalse);
					CyU3PBusyWait (100);

					/* Clear the stall condition and sequence numbers. */
					CyU3PUsbStall (CY_FX_EP_BULK_VIDEO, CyFalse, CyTrue);
					uvcHandleReq = CyTrue;

					/* Complete Control request handshake */
					CyU3PUsbAckSetup ();

					/* Indicate stop streaming to main thread */
					clearFeatureRqtReceived = CyTrue;
					CyFxUVCApplnAbortHandler ();
				}
			}
			break;

		case CY_U3P_USB_TARGET_ENDPT:
			if (bRequest == CY_U3P_USB_SC_CLEAR_FEATURE)
			{
				if (wIndex == CY_FX_EP_BULK_VIDEO)
				{
					/* Windows OS sends Clear Feature Request after it stops streaming,
					 * however MAC OS sends clear feature request right after it sends a
					 * Commit -> SET_CUR request. Hence, stop streaming only if streaming
					 * has started. */
					if (streamingStarted == CyTrue)
					{
						CyU3PDebugPrint (4, "Clear feature request detected..\r\n");

						/* Disable the GPIF state machine. */
						CyU3PGpifDisable (CyFalse);
						streamingStarted = CyFalse;

						/* Place the EP in NAK mode before cleaning up the pipe. */
						CyU3PUsbSetEpNak (CY_FX_EP_BULK_VIDEO, CyTrue);
						CyU3PBusyWait (100);

						/* Reset and flush the endpoint pipe. */
						CyU3PDmaMultiChannelReset (&glChHandleUVCStream);
						CyU3PUsbFlushEp (CY_FX_EP_BULK_VIDEO);
						CyU3PUsbSetEpNak (CY_FX_EP_BULK_VIDEO, CyFalse);
						CyU3PBusyWait (100);

						/* Clear the stall condition and sequence numbers. */
						CyU3PUsbStall (CY_FX_EP_BULK_VIDEO, CyFalse, CyTrue);

						uvcHandleReq = CyTrue;
						/* Complete Control request handshake */
						CyU3PUsbAckSetup ();
						/* Indicate stop streaming to main thread */
						clearFeatureRqtReceived = CyTrue;
						CyFxUVCApplnAbortHandler ();
					}
					else
					{
						uvcHandleReq = CyTrue;
						CyU3PUsbAckSetup ();
					}
				}
			}
			break;

		default:
			break;
	}

	/* Return status of request handling to the USB driver */
	return uvcHandleReq;
}

/* Callback to handle the USB Setup Requests and UVC Class events */
	static CyBool_t
CyFxUVCApplnUSBSetupCB (
		uint32_t setupdat0, /* SETUP Data 0 */
		uint32_t setupdat1  /* SETUP Data 1 */
		)
{
	CyBool_t handled = CyFalse;

	/* Obtain Request Type and Request */
	bmReqType = (uint8_t)(setupdat0 & CY_FX_USB_SETUP_REQ_TYPE_MASK);
	bRequest  = (uint8_t)((setupdat0 & CY_FX_USB_SETUP_REQ_MASK) >> 8);
	wValue    = (uint16_t)((setupdat0 & CY_FX_USB_SETUP_VALUE_MASK) >> 16);
	wIndex    = (uint16_t)(setupdat1 & CY_FX_USB_SETUP_INDEX_MASK);
	wLength   = (uint16_t)((setupdat1 & CY_FX_USB_SETUP_LENGTH_MASK) >> 16);

	uint8_t request_target = bmReqType & CY_U3P_USB_TARGET_MASK;

	switch (request_target) {
		case CY_U3P_USB_TARGET_INTF:
			switch (wIndex & 0xff) {
				case 0:
				case 1:
					handled = uvc_usb_setup_cb();
					break;
				case 2:
				case 3:
					handled = uart_usb_setup_cb(bmReqType, bRequest, wValue);
					break;
			}
			break;
		case CY_U3P_USB_TARGET_ENDPT:
			switch (wIndex & 0xff) {
				case 2:
				case 3:
					handled = uvc_usb_setup_cb();
					break;
				case 4:
				case 5:
				case 6:
					handled = uart_usb_setup_cb(bmReqType, bRequest, wValue);
					break;
			}
			break;
	}

	return handled;
}

/* DMA callback providing notification when data buffers are received from the sensor and when they have
 * been drained by the USB host.
 *
 * The UVC headers are attached to the data, and forwarded to the USB host in this callback function.
 */
	void
CyFxUvcApplnDmaCallback (
		CyU3PDmaMultiChannel *chHandle,
		CyU3PDmaCbType_t      type,
		CyU3PDmaCBInput_t    *input
		)
{
	CyU3PDmaBuffer_t    dmaBuffer;
	CyU3PReturnStatus_t status = CY_U3P_SUCCESS;

	if (type == CY_U3P_DMA_CB_PROD_EVENT)
	{
		/* This is a produce event notification to the CPU. This notification is received upon reception of
		 * every buffer. The buffer will not be sent out unless it is explicitly committed. The call shall fail
		 * if there is a bus reset / usb disconnect or if there is any application error.
		 */

		/* There is a possibility that CyU3PDmaMultiChannelGetBuffer will return CY_U3P_ERROR_INVALID_SEQUENCE here.
		 * In such a case, do nothing. We make up for this missed produce event by making repeated commit actions
		 * in subsequent produce event callbacks.
		 */
		status = CyU3PDmaMultiChannelGetBuffer (chHandle, &dmaBuffer, CYU3P_NO_WAIT);
		while (status == CY_U3P_SUCCESS)
		{
			/* Add Headers*/
			if (dmaBuffer.count == CY_FX_UVC_BUF_FULL_SIZE)
			{
				/* A full buffer indicates there is more data to go in this video frame. */
				CyFxUVCAddHeader (dmaBuffer.buffer - CY_FX_UVC_MAX_HEADER, CY_FX_UVC_HEADER_FRAME);
			}
			else
			{
				/* A partially filled buffer indicates the end of the ongoing video frame. */
				CyFxUVCAddHeader (dmaBuffer.buffer - CY_FX_UVC_MAX_HEADER, CY_FX_UVC_HEADER_EOF);

#ifdef DEBUG_PRINT_FRAME_COUNT
				glFrameCount++;
				glDmaDone = 0;
#endif
			}

			/* Commit Buffer to USB*/
			status = CyU3PDmaMultiChannelCommitBuffer (chHandle, (dmaBuffer.count + CY_FX_UVC_MAX_HEADER), 0);
			if (status == CY_U3P_SUCCESS)
			{
#ifdef DEBUG_PRINT_FRAME_COUNT
				glDmaDone++;
#endif
			}
			else
			{
				CyU3PDebugPrint (4, "Error in CyU3PDmaMultiChannelCommitBuffer: code %d\r\n", status);
				break;
			}

			/* Check if any more buffers are ready to go, and commit them here. */
			status = CyU3PDmaMultiChannelGetBuffer (chHandle, &dmaBuffer, CYU3P_NO_WAIT);
		}
	}
	else if (type == CY_U3P_DMA_CB_CONS_EVENT)
	{
		streamingStarted = CyTrue;
	}
}

/* GpifCB callback function is invoked when FV triggers GPIF interrupt */
	void
CyFxGpifCB (
		uint8_t currentState            /* GPIF state which triggered the interrupt. */
		)
{
	/* The ongoing video frame has ended. If we have a partial buffer sitting on the socket, we need to forcibly
	 * wrap it up. We also need to toggle the FW_TRG a couple of times to get the state machine ready for the
	 * next frame.
	 *
	 * Note: DMA channel APIs cannot be used here as this is ISR context. We are making use of the raw socket
	 * APIs.
	 */

	static uint8_t frame_lines_delay_count = 0;

	switch (currentState)
	{
		case PARTIAL_BUF_IN_SCK0:
#ifdef DEBUG_PRINT_FRAME_COUNT
			glForceWrap++;
#endif /* DEBUG_PRINT_FRAME_COUNT */
			CyU3PDmaSocketSetWrapUp (CY_U3P_PIB_SOCKET_0);
			break;
		case FULL_BUF_IN_SCK0:
#ifdef DEBUG_PRINT_FRAME_COUNT
			glEndFull++;
#endif /* DEBUG_PRINT_FRAME_COUNT */
			break;
		case PARTIAL_BUF_IN_SCK1:
#ifdef DEBUG_PRINT_FRAME_COUNT
			glForceWrap++;
#endif /* DEBUG_PRINT_FRAME_COUNT */
			CyU3PDmaSocketSetWrapUp (CY_U3P_PIB_SOCKET_1);
			break;
		case FULL_BUF_IN_SCK1:
#ifdef DEBUG_PRINT_FRAME_COUNT
			glEndFull++;
#endif /* DEBUG_PRINT_FRAME_COUNT */
			break;

		case PORCH_CPU1:
			if (frame_lines_delay_count < 33 - 1) {
				frame_lines_delay_count++;
				return;
			}
			break;

		case PORCH_CPU0:
			if (frame_lines_delay_count < 33 - 1) {
				frame_lines_delay_count++;
				return;
			}
			break;

		default:
			/* This should not happen. Do nothing. */
			return;
	}

	frame_lines_delay_count = 0;

	CyU3PGpifControlSWInput (CyTrue);
	CyU3PGpifControlSWInput (CyFalse);
}

/* This function initializes the Debug Module for the UVC Application */
	static void
CyFxUVCApplnDebugInit (
		void)
{
	CyU3PUartConfig_t uartConfig;
	CyU3PReturnStatus_t apiRetStatus;

	/* Initialize the UART for printing debug messages */
	apiRetStatus = CyU3PUartInit ();
	if (apiRetStatus != CY_U3P_SUCCESS)
	{
		CyU3PDebugPrint (4, "UART initialization failed!\n");
		CyFxAppErrorHandler (apiRetStatus);
	}

	/* Set UART Configuration */
	uartConfig.baudRate = CY_U3P_UART_BAUDRATE_115200;
	uartConfig.stopBit  = CY_U3P_UART_ONE_STOP_BIT;
	uartConfig.parity   = CY_U3P_UART_NO_PARITY;
	uartConfig.txEnable = CyTrue;
	uartConfig.rxEnable = CyFalse;
	uartConfig.flowCtrl = CyFalse;
	uartConfig.isDma    = CyTrue;

	/* Set the UART configuration */
	apiRetStatus = CyU3PUartSetConfig (&uartConfig, NULL);
	if (apiRetStatus != CY_U3P_SUCCESS)
	{
		CyFxAppErrorHandler (apiRetStatus);
	}

	/* Set the UART transfer */
	apiRetStatus = CyU3PUartTxSetBlockXfer (0xFFFFFFFF);
	if (apiRetStatus != CY_U3P_SUCCESS)
	{
		CyFxAppErrorHandler (apiRetStatus);
	}

	/* Initialize the Debug logger module. */
	apiRetStatus = CyU3PDebugInit (CY_U3P_LPP_SOCKET_UART_CONS, 4);
	if (apiRetStatus != CY_U3P_SUCCESS)
	{
		CyFxAppErrorHandler (apiRetStatus);
	}

	/* Disable log message headers. */
	CyU3PDebugPreamble (CyFalse);
}

/* I2C initialization. */
	static void
CyFxUVCApplnI2CInit (void)
{
	CyU3PI2cConfig_t i2cConfig;;
	CyU3PReturnStatus_t status;

	status = CyU3PI2cInit ();
	if (status != CY_U3P_SUCCESS)
	{
		CyU3PDebugPrint (4, "I2C initialization failed!\n");
		CyFxAppErrorHandler (status);
	}

	/*  Set I2C Configuration */
	i2cConfig.bitRate    = 100000;      /*  100 KHz */
	i2cConfig.isDma      = CyFalse;
	i2cConfig.busTimeout = 0xffffffffU;
	i2cConfig.dmaTimeout = 0xffff;

	status = CyU3PI2cSetConfig (&i2cConfig, 0);
	if (CY_U3P_SUCCESS != status)
	{
		CyU3PDebugPrint (4, "I2C configuration failed!\n");
		CyFxAppErrorHandler (status);
	}
}

#ifdef BACKFLOW_DETECT
static void CyFxUvcAppPibCallback (
		CyU3PPibIntrType cbType,
		uint16_t cbArg)
{
	if ((cbType == CYU3P_PIB_INTR_ERROR) && ((cbArg == 0x1005) || (cbArg == 0x1006)))
	{
		if (!back_flow_detected)
		{
			CyU3PDebugPrint (4, "Backflow detected...\r\n");
			back_flow_detected = 1;
		}
	}
}
#endif

/*
 * Load the GPIF configuration on the GPIF-II engine. This operation is performed at start-up.
 */
	static void
CyFxUvcAppGpifInit (
		void)
{
	CyU3PReturnStatus_t apiRetStatus;

	apiRetStatus =  CyU3PGpifLoad ((CyU3PGpifConfig_t *) &CyFxGpifConfig);
	if (apiRetStatus != CY_U3P_SUCCESS)
	{
		/* Error Handling */
		CyU3PDebugPrint (4, "Loading GPIF Configuration failed, Error Code = %d\r\n", apiRetStatus);
		CyFxAppErrorHandler (apiRetStatus);
	}
}

/* This function initializes the USB Module, creates event group,
   sets the enumeration descriptors, configures the Endpoints and
   configures the DMA module for the UVC Application */
	static void
CyFxUVCApplnInit (void)
{
	CyU3PDmaMultiChannelConfig_t dmaMultiConfig;
	CyU3PEpConfig_t              endPointConfig;
	CyU3PReturnStatus_t          apiRetStatus;
	CyU3PGpioClock_t             gpioClock;
	CyU3PGpioSimpleConfig_t      gpioConfig;
	CyU3PPibClock_t              pibclock;

	/* Create UVC event group */
	apiRetStatus = CyU3PEventCreate (&glFxUVCEvent);
	if (apiRetStatus != 0)
	{
		CyU3PDebugPrint (4, "UVC Create Event failed, Error Code = %d\n", apiRetStatus);
		CyFxAppErrorHandler (apiRetStatus);
	}

	clearFeatureRqtReceived = CyFalse;

	/* Init the GPIO module */
	gpioClock.fastClkDiv = 2;
	gpioClock.slowClkDiv = 2;
	gpioClock.simpleDiv  = CY_U3P_GPIO_SIMPLE_DIV_BY_2;
	gpioClock.clkSrc     = CY_U3P_SYS_CLK;
	gpioClock.halfDiv    = 0;

	/* Initialize Gpio interface */
	apiRetStatus = CyU3PGpioInit (&gpioClock, NULL);
	if (apiRetStatus != 0)
	{
		CyU3PDebugPrint (4, "GPIO Init failed, Error Code = %d\n", apiRetStatus);
		CyFxAppErrorHandler (apiRetStatus);
	}

	/* CTL pins are restricted and cannot be configured using I/O matrix configuration function,
	 * must use GpioOverride to configure it */
	apiRetStatus = CyU3PDeviceGpioOverride (TVP7002_RESET_GPIO, CyTrue);
	if (apiRetStatus != 0)
	{
		CyU3PDebugPrint (4, "GPIO Override failed, Error Code = %d\n", apiRetStatus);
		CyFxAppErrorHandler (apiRetStatus);
	}

	/* SENSOR_RESET_GPIO is the Sensor reset pin */
	gpioConfig.outValue    = CyTrue;
	gpioConfig.driveLowEn  = CyTrue;
	gpioConfig.driveHighEn = CyTrue;
	gpioConfig.inputEn     = CyFalse;
	gpioConfig.intrMode    = CY_U3P_GPIO_NO_INTR;
	apiRetStatus           = CyU3PGpioSetSimpleConfig (TVP7002_RESET_GPIO, &gpioConfig);
	if (apiRetStatus != CY_U3P_SUCCESS)
	{
		CyU3PDebugPrint (4, "GPIO Set Config Error, Error Code = %d\n", apiRetStatus);
		CyFxAppErrorHandler (apiRetStatus);
	}

	/* CTL pins are restricted and cannot be configured using I/O matrix configuration function,
	 * must use GpioOverride to configure it */
	apiRetStatus = CyU3PDeviceGpioOverride (TVP7002_PWDN_GPIO, CyTrue);
	if (apiRetStatus != 0)
	{
		CyU3PDebugPrint (4, "GPIO Override failed, Error Code = %d\n", apiRetStatus);
		CyFxAppErrorHandler (apiRetStatus);
	}

	/* SENSOR_RESET_GPIO is the Sensor reset pin */
	gpioConfig.outValue    = CyTrue;
	gpioConfig.driveLowEn  = CyTrue;
	gpioConfig.driveHighEn = CyTrue;
	gpioConfig.inputEn     = CyFalse;
	gpioConfig.intrMode    = CY_U3P_GPIO_NO_INTR;
	apiRetStatus           = CyU3PGpioSetSimpleConfig (TVP7002_PWDN_GPIO, &gpioConfig);
	if (apiRetStatus != CY_U3P_SUCCESS)
	{
		CyU3PDebugPrint (4, "GPIO Set Config Error, Error Code = %d\n", apiRetStatus);
		CyFxAppErrorHandler (apiRetStatus);
	}

	/* Initialize the P-port. */
	pibclock.clkDiv      = 2;
	pibclock.clkSrc      = CY_U3P_SYS_CLK;
	pibclock.isDllEnable = CyFalse;
	pibclock.isHalfDiv   = CyFalse;

	apiRetStatus = CyU3PPibInit (CyTrue, &pibclock);
	if (apiRetStatus != CY_U3P_SUCCESS)
	{
		CyU3PDebugPrint (4, "PIB Function Failed to Start, Error Code = %d\n", apiRetStatus);
		CyFxAppErrorHandler (apiRetStatus);
	}

	CyFxUvcAppGpifInit ();

	/* Register the GPIF State Machine callback used to get frame end notifications.
	 * We use the fast callback version which is triggered from ISR context.
	 */
	CyU3PGpifRegisterSMIntrCallback (CyFxGpifCB);

#ifdef BACKFLOW_DETECT
	back_flow_detected = 0;
	CyU3PPibRegisterCallback (CyFxUvcAppPibCallback, CYU3P_PIB_INTR_ERROR);
#endif

	/* Image sensor initialization. Reset and then initialize with appropriate configuration. */
	CyU3PThreadSleep(100);

	/* USB initialization. */
	apiRetStatus = CyU3PUsbStart ();
	if (apiRetStatus != CY_U3P_SUCCESS)
	{
		CyU3PDebugPrint (4, "USB Function Failed to Start, Error Code = %d\n", apiRetStatus);
		CyFxAppErrorHandler (apiRetStatus);
	}

	/* Setup the Callback to Handle the USB Setup Requests */
	CyU3PUsbRegisterSetupCallback (CyFxUVCApplnUSBSetupCB, CyFalse);

	/* Setup the Callback to Handle the USB Events */
	CyU3PUsbRegisterEventCallback (CyFxUVCApplnUSBEventCB);

	/* Register the USB device descriptors with the driver. */
	CyU3PUsbSetDesc (CY_U3P_USB_SET_HS_DEVICE_DESCR, 0, (uint8_t *)UsbDescriptorDeviceUsb2);
	CyU3PUsbSetDesc (CY_U3P_USB_SET_SS_DEVICE_DESCR, 0, (uint8_t *)UsbDescriptorDeviceUsb3);

	/* BOS and Device qualifier descriptors. */
	CyU3PUsbSetDesc (CY_U3P_USB_SET_DEVQUAL_DESCR, 0, (uint8_t *)UsbDescriptorDeviceQualifier);
	CyU3PUsbSetDesc (CY_U3P_USB_SET_SS_BOS_DESCR, 0, (uint8_t *)UsbDescriptorBOS);

	/* Configuration descriptors. */
	CyU3PUsbSetDesc (CY_U3P_USB_SET_HS_CONFIG_DESCR, 0, (uint8_t *)CyFxUSBHSConfigDscr);
	CyU3PUsbSetDesc (CY_U3P_USB_SET_FS_CONFIG_DESCR, 0, (uint8_t *)UsbDescriptorConfigurationFS);
	CyU3PUsbSetDesc (CY_U3P_USB_SET_SS_CONFIG_DESCR, 0, (uint8_t *)UsbDescriptorConfigurationSS);

	/* String Descriptors */
	CyU3PUsbSetDesc (CY_U3P_USB_SET_STRING_DESCR, 0, (uint8_t *)UsbDescriptorStringLangid);
	CyU3PUsbSetDesc (CY_U3P_USB_SET_STRING_DESCR, 1, (uint8_t *)UsbDescriptorStringManufacturer);
	CyU3PUsbSetDesc (CY_U3P_USB_SET_STRING_DESCR, 2, (uint8_t *)UsbDescriptorStringProduct);

	/* Configure the video streaming endpoint. */
	endPointConfig.enable   = 1;
	endPointConfig.epType   = CY_U3P_USB_EP_BULK;
	endPointConfig.pcktSize = CY_FX_EP_BULK_VIDEO_PKT_SIZE;
	endPointConfig.isoPkts  = 1;
	endPointConfig.burstLen = 16;
	endPointConfig.streams  = 0;
	apiRetStatus = CyU3PSetEpConfig (CY_FX_EP_BULK_VIDEO, &endPointConfig);
	if (apiRetStatus != CY_U3P_SUCCESS)
	{
		/* Error Handling */
		CyU3PDebugPrint (4, "USB Set Endpoint config failed, Error Code = %d\n", apiRetStatus);
		CyFxAppErrorHandler (apiRetStatus);
	}

	/* Configure the status interrupt endpoint.
Note: This endpoint is not being used by the application as of now. This can be used in case
UVC device needs to notify the host about any error conditions. A MANUAL_OUT DMA channel
can be associated with this endpoint and used to send these data packets.
*/
	endPointConfig.enable   = 1;
	endPointConfig.epType   = CY_U3P_USB_EP_INTR;
	endPointConfig.pcktSize = 64;
	endPointConfig.isoPkts  = 0;
	endPointConfig.streams  = 0;
	endPointConfig.burstLen = 1;
	apiRetStatus = CyU3PSetEpConfig (CY_FX_EP_CONTROL_STATUS, &endPointConfig);
	if (apiRetStatus != CY_U3P_SUCCESS)
	{
		/* Error Handling */
		CyU3PDebugPrint (4, "USB Set Endpoint config failed, Error Code = %d\n", apiRetStatus);
		CyFxAppErrorHandler (apiRetStatus);
	}

	/* Create a DMA Manual channel for sending the video data to the USB host. */
	dmaMultiConfig.size           = CY_FX_UVC_STREAM_BUF_SIZE;
	dmaMultiConfig.count          = CY_FX_UVC_STREAM_BUF_COUNT;
	dmaMultiConfig.validSckCount  = 2;
	dmaMultiConfig.prodSckId [0]  = (CyU3PDmaSocketId_t)CY_U3P_PIB_SOCKET_0;
	dmaMultiConfig.prodSckId [1]  = (CyU3PDmaSocketId_t)CY_U3P_PIB_SOCKET_1;
	dmaMultiConfig.consSckId [0]  = (CyU3PDmaSocketId_t)(CY_U3P_UIB_SOCKET_CONS_0 | CY_FX_EP_VIDEO_CONS_SOCKET);
	dmaMultiConfig.prodAvailCount = 0;
	dmaMultiConfig.prodHeader     = 12;                 /* 12 byte UVC header to be added. */
	dmaMultiConfig.prodFooter     = 4;                  /* 4 byte footer to compensate for the 12 byte header. */
	dmaMultiConfig.consHeader     = 0;
	dmaMultiConfig.dmaMode        = CY_U3P_DMA_MODE_BYTE;
	dmaMultiConfig.notification   = CY_U3P_DMA_CB_PROD_EVENT | CY_U3P_DMA_CB_CONS_EVENT;
	dmaMultiConfig.cb             = CyFxUvcApplnDmaCallback;
	apiRetStatus = CyU3PDmaMultiChannelCreate (&glChHandleUVCStream, CY_U3P_DMA_TYPE_MANUAL_MANY_TO_ONE,
			&dmaMultiConfig);
	if (apiRetStatus != CY_U3P_SUCCESS)
	{
		/* Error handling */
		CyU3PDebugPrint (4, "DMA Channel Creation Failed, Error Code = %d\n", apiRetStatus);
		CyFxAppErrorHandler (apiRetStatus);
	}

	/* Enable USB connection from the FX3 device, preferably at USB 3.0 speed. */
	apiRetStatus = CyU3PConnectState (CyTrue, CyTrue);
	if (apiRetStatus != CY_U3P_SUCCESS)
	{
		CyU3PDebugPrint (4, "USB Connect failed, Error Code = %d\n", apiRetStatus);
		CyFxAppErrorHandler (apiRetStatus);
	}
}

/*
 * Entry function for the UVC Application Thread
 */
void UVCAppThread_Entry (uint32_t input) {
	CyU3PReturnStatus_t apiRetStatus;
	uint32_t            flag;

	/* Initialize the Uart Debug Module */
	/* CyFxUVCApplnDebugInit (); */
    /* CyU3PDebugPrint(4, "Debug initialized ...\n"); */

	/* Initialize the I2C interface */
	CyFxUVCApplnI2CInit ();

	// init uart
	uart_init();

	/* Initialize the UVC Application */
	CyFxUVCApplnInit ();

	CyU3PDebugPrint(4, "Finished initialization ...\n");

	apiRetStatus = tvp7002_init();
	if (apiRetStatus != CY_U3P_SUCCESS) {
		CyU3PDebugPrint(4, "Failed to initialize tvp7002: %d", apiRetStatus);
	}
	//
	//    for (;;) {
	CyU3PThreadSleep(1000);
	tvp7002_print_debug_info();
	//    }

	/*
	   The actual data forwarding from sensor to USB host is done from the DMA and GPIF callback
	   functions. The thread is only responsible for checking for streaming start/stop conditions.

	   The CY_FX_UVC_STREAM_EVENT event flag will indicate that the UVC video stream should be started.

	   The CY_FX_UVC_STREAM_ABORT_EVENT event indicates that we need to abort the video streaming. This
	   only happens when we receive a CLEAR_FEATURE request indicating that streaming is to be stopped,
	   or when we have a critical error in the data path.
	   */
	for (;;)
	{
		apiRetStatus = CyU3PEventGet (&glFxUVCEvent, CY_FX_UVC_STREAM_ABORT_EVENT | CY_FX_UVC_STREAM_EVENT,
				CYU3P_EVENT_OR_CLEAR, &flag, LOOP_TIMEOUT);

		if (apiRetStatus == CY_U3P_SUCCESS)
		{
			/* Request to start video stream. */
			if ((flag & CY_FX_UVC_STREAM_EVENT) != 0)
			{
#ifdef DEBUG_PRINT_FRAME_COUNT
				/* Clear state variables. */
				glDmaDone    = 1;
				glFrameCount = 0;
				glForceWrap = 0;
				glEndFull = 0;
#endif /* DEBUG_PRINT_FRAME_COUNT */

				/* Start with frame ID 0. */
				glUVCHeader[1] &= ~CY_FX_UVC_HEADER_FRAME_ID;

				/* Make sure we return to an active USB link state and stay there. */
				CyU3PUsbLPMDisable ();
				if (CyU3PUsbGetSpeed () == CY_U3P_SUPER_SPEED)
				{
					CyU3PUsbSetLinkPowerState (CyU3PUsbLPM_U0);
					CyU3PBusyWait (200);
				}
				else
				{
					CyU3PUsb2Resume ();
				}

				/* Set DMA Channel transfer size, first producer socket */
				apiRetStatus = CyU3PDmaMultiChannelSetXfer (&glChHandleUVCStream, 0, 0);
				if (apiRetStatus != CY_U3P_SUCCESS)
				{
					/* Error handling */
					CyU3PDebugPrint (4, "DMA Channel Set Transfer Failed, Error Code = %d\r\n", apiRetStatus);
					CyFxAppErrorHandler (apiRetStatus);
				}

				/* Start the state machine from the designated start state. */
				apiRetStatus = CyU3PGpifSMStart (START_SCK0, ALPHA_START_SCK0);
				if (apiRetStatus != CY_U3P_SUCCESS)
				{
					/* Error Handling */
					CyU3PDebugPrint (4, "Starting GPIF state machine failed, Error Code = %d\r\n", apiRetStatus);
					CyFxAppErrorHandler (apiRetStatus);
				}
			}

			/* Video stream abort requested. */
			if ((flag & CY_FX_UVC_STREAM_ABORT_EVENT) != 0)
			{
#ifdef DEBUG_PRINT_FRAME_COUNT
				/* Clear state variables. */
				glDmaDone    = 1;
				glFrameCount = 0;
				glForceWrap = 0;
				glEndFull = 0;
#endif /* DEBUG_PRINT_FRAME_COUNT */

				if (!clearFeatureRqtReceived)
				{
					apiRetStatus = CyU3PDmaMultiChannelReset (&glChHandleUVCStream);
					if (apiRetStatus != CY_U3P_SUCCESS)
					{
						CyFxAppErrorHandler (apiRetStatus);
					}

					/* Flush the Endpoint memory */
					CyU3PUsbFlushEp (CY_FX_EP_BULK_VIDEO);
				}

				clearFeatureRqtReceived = CyFalse;

				/* Allow USB low power link transitions at this stage. */
				CyU3PUsbLPMEnable ();
			}
		}

#ifdef DEBUG_PRINT_FRAME_COUNT
		CyU3PDebugPrint (4, "UVC: Completed %d frames and %d buffers\r\n", glFrameCount,
				(glDmaDone != 0) ? (glDmaDone - 1) : 0);
		CyU3PDebugPrint (4, "Force wrapped %d, full end %d buffers.\r\n", glForceWrap, glEndFull);
#endif
	}
}

/*
 * Handler for control requests addressed to the Processing Unit.
 */
	static void
UVCHandleProcessingUnitRqts (
		void)
{
	CyU3PUsbStall (0, CyTrue, CyFalse);
}

/*
 * Handler for control requests addressed to the UVC Camera Terminal unit.
 */
	static void
UVCHandleCameraTerminalRqts (
		void)
{
	CyU3PUsbStall (0, CyTrue, CyFalse);
}

/*
 * Handler for UVC Interface control requests.
 */
	static void
UVCHandleInterfaceCtrlRqts (
		void)
{
	/* No requests supported as of now. Just stall EP0 to fail the request. */
	CyU3PUsbStall (0, CyTrue, CyFalse);
}

/*
 * Handler for control requests addressed to the Extension Unit.
 */
	static void
UVCHandleExtensionUnitRqts (
		void)
{
	/* No requests supported as of now. Just stall EP0 to fail the request. */
	CyU3PUsbStall (0, CyTrue, CyFalse);
}

/*
 * Handler for the video streaming control requests.
 */
	static void
UVCHandleVideoStreamingRqts (
		void)
{
	CyU3PReturnStatus_t apiRetStatus = CY_U3P_SUCCESS;
	uint16_t readCount;

	switch (wValue)
	{
		case CY_FX_UVC_PROBE_CTRL:
			switch (bRequest)
			{
				case CY_FX_USB_UVC_GET_INFO_REQ:
					glEp0Buffer[0] = 3;                /* GET/SET requests are supported. */
					CyU3PUsbSendEP0Data (1, (uint8_t *)glEp0Buffer);
					break;
				case CY_FX_USB_UVC_GET_LEN_REQ:
					glEp0Buffer[0] = CY_FX_UVC_MAX_PROBE_SETTING;
					CyU3PUsbSendEP0Data (1, (uint8_t *)glEp0Buffer);
					break;
				case CY_FX_USB_UVC_GET_CUR_REQ:
				case CY_FX_USB_UVC_GET_MIN_REQ:
				case CY_FX_USB_UVC_GET_MAX_REQ:
				case CY_FX_USB_UVC_GET_DEF_REQ: /* There is only one setting per USB speed. */
					if (usbSpeed == CY_U3P_SUPER_SPEED)
					{
						CyU3PUsbSendEP0Data (CY_FX_UVC_MAX_PROBE_SETTING, (uint8_t *)glProbeCtrl);
					}
					else
					{
						CyU3PUsbSendEP0Data (CY_FX_UVC_MAX_PROBE_SETTING, (uint8_t *)glProbeCtrl20);
					}
					break;
				case CY_FX_USB_UVC_SET_CUR_REQ:
					apiRetStatus = CyU3PUsbGetEP0Data (CY_FX_UVC_MAX_PROBE_SETTING_ALIGNED,
							glCommitCtrl, &readCount);
					if (apiRetStatus == CY_U3P_SUCCESS)
					{
						if (usbSpeed == CY_U3P_SUPER_SPEED)
						{
							/* Copy the relevant settings from the host provided data into the
							   active data structure. */
							glProbeCtrl[2] = glCommitCtrl[2];
							glProbeCtrl[3] = glCommitCtrl[3];
							glProbeCtrl[4] = glCommitCtrl[4];
							glProbeCtrl[5] = glCommitCtrl[5];
							glProbeCtrl[6] = glCommitCtrl[6];
							glProbeCtrl[7] = glCommitCtrl[7];
						}
					}
					break;
				default:
					CyU3PUsbStall (0, CyTrue, CyFalse);
					break;
			}
			break;

		case CY_FX_UVC_COMMIT_CTRL:
			switch (bRequest)
			{
				case CY_FX_USB_UVC_GET_INFO_REQ:
					glEp0Buffer[0] = 3;                        /* GET/SET requests are supported. */
					CyU3PUsbSendEP0Data (1, (uint8_t *)glEp0Buffer);
					break;
				case CY_FX_USB_UVC_GET_LEN_REQ:
					glEp0Buffer[0] = CY_FX_UVC_MAX_PROBE_SETTING;
					CyU3PUsbSendEP0Data (1, (uint8_t *)glEp0Buffer);
					break;
				case CY_FX_USB_UVC_GET_CUR_REQ:
					if (usbSpeed == CY_U3P_SUPER_SPEED)
					{
						CyU3PUsbSendEP0Data (CY_FX_UVC_MAX_PROBE_SETTING, (uint8_t *)glProbeCtrl);
					}
					else
					{
						CyU3PUsbSendEP0Data (CY_FX_UVC_MAX_PROBE_SETTING, (uint8_t *)glProbeCtrl20);
					}
					break;
				case CY_FX_USB_UVC_SET_CUR_REQ:
					/* The host has selected the parameters for the video stream. Check the desired
					   resolution settings, configure the sensor and start the video stream.
					   */
					apiRetStatus = CyU3PUsbGetEP0Data (CY_FX_UVC_MAX_PROBE_SETTING_ALIGNED,
							glCommitCtrl, &readCount);
					if (apiRetStatus == CY_U3P_SUCCESS)
					{
						if (usbSpeed == CY_U3P_SUPER_SPEED)
						{
							tvp7002_stream();
						}
						//else
						//{
						//    SensorScaling_VGA ();
						//}

						/* We can start streaming video now. */
						apiRetStatus = CyU3PEventSet (&glFxUVCEvent, CY_FX_UVC_STREAM_EVENT, CYU3P_EVENT_OR);
						if (apiRetStatus != CY_U3P_SUCCESS)
						{
							CyU3PDebugPrint (4, "Set CY_FX_UVC_STREAM_EVENT failed %x\n", apiRetStatus);
						}
					}
					break;

				default:
					CyU3PUsbStall (0, CyTrue, CyFalse);
					break;
			}
			break;

		default:
			CyU3PUsbStall (0, CyTrue, CyFalse);
			break;
	}
}

/*
 * Entry function for the UVC control request processing thread.
 */
void UVCAppEP0Thread_Entry (uint32_t input) {
	uint32_t eventMask = (CY_FX_UVC_VIDEO_CONTROL_REQUEST_EVENT | CY_FX_UVC_VIDEO_STREAM_REQUEST_EVENT);
	uint32_t eventFlag;

	for (;;)
	{
		/* Wait for a Video control or streaming related request on the control endpoint. */
		if (CyU3PEventGet (&glFxUVCEvent, eventMask, CYU3P_EVENT_OR_CLEAR, &eventFlag,
					CYU3P_WAIT_FOREVER) == CY_U3P_SUCCESS)
		{
			usbSpeed = CyU3PUsbGetSpeed ();

			if (eventFlag & CY_FX_UVC_VIDEO_CONTROL_REQUEST_EVENT)
			{
				switch ((wIndex >> 8))
				{
					/* case CY_FX_UVC_PROCESSING_UNIT_ID: */
					/*     UVCHandleProcessingUnitRqts (); */
					/*     break; */
					/*  */
					/* case CY_FX_UVC_CAMERA_TERMINAL_ID: */
					/*     UVCHandleCameraTerminalRqts (); */
					/*     break; */
					/*  */
					case CY_FX_UVC_INTERFACE_CTRL:
						UVCHandleInterfaceCtrlRqts ();
						break;

						/* case CY_FX_UVC_EXTENSION_UNIT_ID: */
						/* UVCHandleExtensionUnitRqts (); */
						/* break; */

					default:
						/* Unsupported request. Fail by stalling the control endpoint. */
						CyU3PUsbStall (0, CyTrue, CyFalse);
						break;
				}
			}

			if (eventFlag & CY_FX_UVC_VIDEO_STREAM_REQUEST_EVENT)
			{
				if (wIndex != CY_FX_UVC_STREAM_INTERFACE)
				{
					CyU3PUsbStall (0, CyTrue, CyFalse);
				}
				else
				{
					UVCHandleVideoStreamingRqts ();
				}
			}
		}

		/* Allow other ready threads to run. */
		CyU3PThreadRelinquish ();
	}
}
