domenipavec/usb-vga-computer-control/avr-firmware/usb.cpp

/* File: usb.cpp
 * Usb handling
 */
/* Copyright (c) 2012-2013 Domen Ipavec (domen.ipavec@z-v.si)
 *
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
 * THE SOFTWARE IS PROVIDED "AS IS", WITHOUT WARRANTY OF ANY KIND,
 * EXPRESS OR IMPLIED, INCLUDING BUT NOT LIMITED TO THE WARRANTIES OF
 * MERCHANTABILITY, FITNESS FOR A PARTICULAR PURPOSE AND
 * NONINFRINGEMENT. IN NO EVENT SHALL THE AUTHORS OR COPYRIGHT HOLDERS
 * BE LIABLE FOR ANY CLAIM, DAMAGES OR OTHER LIABILITY, WHETHER IN AN
 * ACTION OF CONTRACT, TORT OR OTHERWISE, ARISING FROM, OUT OF OR IN
 * CONNECTION WITH THE SOFTWARE OR THE USE OR OTHER DEALINGS IN THE
 * SOFTWARE.
 */

#include "usb.h"
#include "uart.h"

#include <avr/pgmspace.h>
#include <avr/interrupt.h>
#include <util/delay.h>

#include "bitop.h"

PROGMEM const char usbHidReportDescriptor[USB_CFG_HID_REPORT_DESCRIPTOR_LENGTH] = { /* USB report descriptor, size must match usbconfig.h */
    0x05, 0x01,                    // USAGE_PAGE (Generic Desktop)
    0x09, 0x02,                    // USAGE (Mouse)
    0xa1, 0x01,                    // COLLECTION (Application)
    0x09, 0x01,                    //   USAGE (Pointer)
    0xa1, 0x00,                    //   COLLECTION (Physical)
    0x85, 0x01,                    //     REPORT_ID (1)
    0x05, 0x09,                    //     USAGE_PAGE (Button)
    0x19, 0x01,                    //     USAGE_MINIMUM (Button 1)
    0x29, 0x03,                    //     USAGE_MAXIMUM (Button 3)
    0x15, 0x00,                    //     LOGICAL_MINIMUM (0)
    0x25, 0x01,                    //     LOGICAL_MAXIMUM (1)
    0x95, 0x03,                    //     REPORT_COUNT (3)
    0x75, 0x01,                    //     REPORT_SIZE (1)
    0x81, 0x02,                    //     INPUT (Data,Var,Abs)
    0x95, 0x01,                    //     REPORT_COUNT (1)
    0x75, 0x05,                    //     REPORT_SIZE (5)
    0x81, 0x03,                    //     INPUT (Cnst,Var,Abs)
    0x05, 0x01,                    //     USAGE_PAGE (Generic Desktop)
    0x09, 0x30,                    //     USAGE (X)
    0x09, 0x31,                    //     USAGE (Y)
    0x15, 0x81,                    //     LOGICAL_MINIMUM (-127)
    0x25, 0x7f,                    //     LOGICAL_MAXIMUM (127)
    0x75, 0x08,                    //     REPORT_SIZE (8)
    0x95, 0x02,                    //     REPORT_COUNT (2)
    0x81, 0x06,                    //     INPUT (Data,Var,Rel)
    0xc0,                          //   END_COLLECTION
    0xc0,                          // END_COLLECTION
    0x05, 0x01,                    // USAGE_PAGE (Generic Desktop)
    0x09, 0x06,                    // USAGE (Keyboard)
    0xa1, 0x01,                    // COLLECTION (Application)
    0x85, 0x02,                    //   REPORT_ID (2)
    0x05, 0x07,                    //   USAGE_PAGE (Keyboard)
    0x19, 0xe0,                    //   USAGE_MINIMUM (Keyboard LeftControl)
    0x29, 0xe7,                    //   USAGE_MAXIMUM (Keyboard Right GUI)
    0x15, 0x00,                    //   LOGICAL_MINIMUM (0)
    0x25, 0x01,                    //   LOGICAL_MAXIMUM (1)
    0x75, 0x01,                    //   REPORT_SIZE (1)
    0x95, 0x08,                    //   REPORT_COUNT (8)
    0x81, 0x02,                    //   INPUT (Data,Var,Abs)
    0x95, 0x01,                    //   REPORT_COUNT (1)
    0x75, 0x08,                    //   REPORT_SIZE (8)
    0x81, 0x03,                    //   INPUT (Cnst,Var,Abs)
    0x95, 0x05,                    //   REPORT_COUNT (5)
    0x75, 0x01,                    //   REPORT_SIZE (1)
    0x05, 0x08,                    //   USAGE_PAGE (LEDs)
    0x19, 0x01,                    //   USAGE_MINIMUM (Num Lock)
    0x29, 0x05,                    //   USAGE_MAXIMUM (Kana)
    0x91, 0x02,                    //   OUTPUT (Data,Var,Abs)
    0x95, 0x01,                    //   REPORT_COUNT (1)
    0x75, 0x03,                    //   REPORT_SIZE (3)
    0x91, 0x03,                    //   OUTPUT (Cnst,Var,Abs)
    0x95, 0x06,                    //   REPORT_COUNT (6)
    0x75, 0x08,                    //   REPORT_SIZE (8)
    0x15, 0x00,                    //   LOGICAL_MINIMUM (0)
    0x25, 0x65,                    //   LOGICAL_MAXIMUM (101)
    0x05, 0x07,                    //   USAGE_PAGE (Keyboard)
    0x19, 0x00,                    //   USAGE_MINIMUM (Reserved (no event indicated))
    0x29, 0x65,                    //   USAGE_MAXIMUM (Keyboard Application)
    0x81, 0x00,                    //   INPUT (Data,Ary,Abs)
    0xc0,                          // END_COLLECTION
    0x05, 0x0d,                    // USAGE_PAGE (Digitizers)
    0x09, 0x02,                    // USAGE (Pen)
    0xa1, 0x01,                    // COLLECTION (Application)
    0x09, 0x20,                    //   USAGE (Stylus)
    0xa1, 0x00,                    //   COLLECTION (Physical)
    0x85, 0x03,                    //     REPORT_ID (3)
    0x05, 0x0d,                    //     USAGE_PAGE (Digitizers)
    0x09, 0x42,                    //     USAGE (Tip Switch)
    0x09, 0x32,                    //     USAGE (In Range)
    0x15, 0x00,                    //     LOGICAL_MINIMUM (0)
    0x25, 0x01,                    //     LOGICAL_MAXIMUM (1)
    0x75, 0x01,                    //     REPORT_SIZE (1)
    0x95, 0x02,                    //     REPORT_COUNT (2)
    0x81, 0x02,                    //     INPUT (Data,Var,Abs)
    0x75, 0x01,                    //     REPORT_SIZE (1)
    0x95, 0x06,                    //     REPORT_COUNT (6)
    0x81, 0x03,                    //     INPUT (Cnst,Var,Abs)
    0x05, 0x01,                    //     USAGE_PAGE (Generic Desktop)
    0x09, 0x01,                    //     USAGE (Pointer)
    0xa1, 0x00,                    //     COLLECTION (Physical)
    0x09, 0x30,                    //       USAGE (X)
    0x09, 0x31,                    //       USAGE (Y)
    0x15, 0x00,                    //       LOGICAL_MINIMUM (0)
    0x26, 0xff, 0x7f,              //       LOGICAL_MAXIMUM (32767)
    0x35, 0x00,                    //       PHYSICAL_MINIMUM (0)
    0x46, 0xff, 0x7f,              //       PHYSICAL_MAXIMUM (32767)
    0x65, 0x00,                    //       UNIT (None)
    0x75, 0x10,                    //       REPORT_SIZE (16)
    0x95, 0x02,                    //       REPORT_COUNT (2)
    0x81, 0x02,                    //       INPUT (Data,Var,Abs)
    0xc0,                          //     END_COLLECTION
    0xc0,                          //   END_COLLECTION
    0xc0                           // END_COLLECTION
};

volatile hid_report_mouse_rel_t hid_report_mouse_rel = {
	.report_id = 1,
	.buttonMask = 0,
	.dx = 0,
	.dy = 0,
};

volatile hid_report_keyboard_t hid_report_keyboard = {
	.report_id = 2,
	.modifier = 0,
	.reserved = 0,
	.keycode = {0, 0, 0, 0, 0, 0},
};

volatile hid_report_mouse_abs_t hid_report_mouse_abs = {
	.report_id = 3,
	.buttonMask = 2,
	.x = {0},
	.y = {0},
};

volatile uint8_t hid_report_dirty = 0;


static uchar    idleRate;   /* repeat rate for keyboards, never used for mice */

usbMsgLen_t usbFunctionSetup(uchar data[8])
{
usbRequest_t    *rq = (usbRequest_t *)data;

    /* The following requests are never used. But since they are required by
     * the specification, we implement them in this example.
     */
    if((rq->bmRequestType & USBRQ_TYPE_MASK) == USBRQ_TYPE_CLASS){    /* class request type */
        if(rq->bRequest == USBRQ_HID_GET_REPORT){  /* wValue: ReportType (highbyte), ReportID (lowbyte) */
			usbMsgLen_t size = 0;
			switch (rq->wValue.bytes[0]) { // switch on report id
				case 1:
					usbMsgPtr = (uint16_t)&hid_report_mouse_rel;
					size = sizeof(hid_report_mouse_rel_t);
					break;
				case 2:
					usbMsgPtr = (uint16_t)&hid_report_keyboard;
					size = sizeof(hid_report_keyboard_t);
					break;
				case 3:
					usbMsgPtr = (uint16_t)&hid_report_mouse_abs;
					size = sizeof(hid_report_mouse_abs_t);
					break;
			}
            return size;
        }else if(rq->bRequest == USBRQ_HID_GET_IDLE){
            usbMsgPtr = (uint16_t)&idleRate;
            return 1;
        }else if(rq->bRequest == USBRQ_HID_SET_IDLE){
            idleRate = rq->wValue.bytes[1];
        }
    }else{
        /* no vendor specific requests implemented */
    }
    return 0;   /* default for not implemented requests: return no data back to host */
}


void usb_init() {
	usbDeviceDisconnect();
	uint8_t i = 0;
	while(--i){         // fake USB disconnect for > 250 ms
		// wdt_reset();    // if watchdog is active, reset it
		_delay_ms(1);   // library call -- has limited range
	}
	usbDeviceConnect();

	usbInit();
}

void usb_loop() {
	static int8_t to_send = 0;
	static uint8_t *hid_report;

	usbPoll();

	if (usbInterruptIsReady()) {
		cli();
		if (to_send == 0) {
			if (BITSET(hid_report_dirty, HID_REPORT_MOUSE_REL_DIRTY)) {
				CLEARBIT(hid_report_dirty, HID_REPORT_MOUSE_REL_DIRTY);
				to_send = sizeof(hid_report_mouse_rel);
				hid_report = (uint8_t *)&hid_report_mouse_rel;
			} else if (BITSET(hid_report_dirty, HID_REPORT_KEYBOARD_DIRTY)) {
				CLEARBIT(hid_report_dirty, HID_REPORT_KEYBOARD_DIRTY);
				to_send = sizeof(hid_report_keyboard);
				hid_report = (uint8_t *)&hid_report_keyboard;
			} else if (BITSET(hid_report_dirty, HID_REPORT_MOUSE_ABS_DIRTY)) {
				CLEARBIT(hid_report_dirty, HID_REPORT_MOUSE_ABS_DIRTY);
				to_send = sizeof(hid_report_mouse_abs);
				hid_report = (uint8_t *)&hid_report_mouse_abs;
			}
		}
		if (to_send > 8) {
			usbSetInterrupt(hid_report, 8);
			to_send -= 8;
			hid_report += 8;
		} else if (to_send == 8) {
			usbSetInterrupt(hid_report, 8);
			to_send = -1;
		} else if (to_send > 0) {
			usbSetInterrupt(hid_report, to_send);
			to_send = 0;
		} else if (to_send == -1) {
			usbSetInterrupt(hid_report, 0);
			to_send = 0;
		}
		sei();
	}
}
