domenipavec/usb-vga-computer-control/(commit log)

2016-12-07 First prototype pcb
    [avr.sch, cyusb.sch, prototype1.kicad_pcb, prototype1.sch, tvp7002.sch, vga.sch]
2016-12-07 Example project with tvp init, not working
    [cyfxuvcdscr.c, i2c.c, i2c.h, tvp7002.c, tvp7002.h, uvc.c, uvc.h]
2016-12-07 Remove camera ptzcontrol code
2016-12-20 Added power control i2c command
2016-12-28 Control mouse with uart
2016-12-29 Moved kicad files
    [avr.sch, cyusb.sch, prototype1.kicad_pcb, prototype1.sch, tvp7002.sch, vga.sch]
2016-12-29 Added uart-script
2016-12-29 Updated to new kicad
    [avr.sch, cyusb.sch, prototype1.sch, tvp7002.sch, vga.sch]
2017-01-03 Final prototype 2 board
    [avr.sch, cyusb.sch, power.sch, prototype1.kicad_pcb, prototype1.sch, tvp7002.sch, usb3.sch, vga.sch]
2017-01-07 usbgen for device descriptors
2017-01-07 Device qualifier and bos descriptors with usbgen
2017-01-08 Added uart descriptors
2017-01-10 Moved thread creation to main.c
2017-01-10 Disable uart debug
2017-01-11 Working uart
2017-01-12 Generic uart script for command line messages
2017-01-15 Added config for pull up to pin
2017-01-15 Added ability to choose video device
2018-02-05 Update for small device
